font-weight/sorter_esp32/firmware/motion_node/README.md

# Управляющая ESP32: подготовленная прошивка сортировщика

**Принятый вариант: боковой заход +Y на 25 мм. Пользователь подтвердил: «Все. работает. Оставляй».** В arm_calibration команды SORT и CHECKPICK сначала подводят захват к (X,Y−25) на верхнем уровне, опускают там, затем перемещают открытый захват к (X,Y) по нижней карте. Детали должны находиться при X=20…130, Y=50…80 мм. После закрытия выполняется подъём у детали. Пользователь сообщил, что при прежнем отступе 15 мм рука всё равно упёрлась. Отступ 25 мм для кубика размером 30 мм задаёт начало на 10 мм перед ближней гранью. Пользователь подтвердил работу этого варианта; координаты и число выполненных переносов не сообщены. Подробности — в начале `firmware/arm_calibration/README.md`. Настройка сохранена; для её принятия повторная прошивка не требуется.

**История до принятия бокового захода 25 мм: неудачный захват SORT от 12.10.2026.** Пользователь сообщил, что у обоих кубиков рука ушла примерно на 10 мм вперёд и прижала их сверху. Уточнено направление +Y. После неудачного захвата пользователь сам передвинул кубик: уменьшение числа объектов и SORT_PICK_DONE не подтверждают физический перенос и не доказывают ошибку камеры. Момент появления смещения пока неизвестен. Результат записан в `measurements/commissioning/stage17_result.json`. После этой неудачи изменён способ подхода; работу варианта с отступом 25 мм пользователь впоследствии подтвердил. Программные проверки не подтверждают физическую точность захвата.

После местной поправки пользователь измерил HIGH=115/46/103, NEAR=115/46/30, LOW=115/46/10 мм. Все три остановки имеют одинаковые X/Y в пределах записанных измерений, с остаточным смещением Y=+3,7 мм от прежней цели. После упора при боковом подходе на 15 мм пользователь увеличил отступ до 25 мм. Эти местные ручные позы сохранены как измерения; глобальная карта автоматически ими не заменяется.

**Текущий режим motion_node — виртуальный, физические PWM выключены.** В `LocalConfig.h` сохранена карта нынешней MeArm; PARK по просьбе пользователя заменён импульсами **1500,1200,1500,2100**, его XYZ ещё не измерены и measured_ok=false. Значение `parkOpen.tip` временно взято из HUB только для численного виртуального профиля, оно не описывает физический PARK. Повторяемость, точность интерполяции и просветы всех маршрутов ещё не подтверждены: `geometryConfirmed`, `routesVerified`, `parkSupported` остаются `false`. Записанная карта пока не допускает аппаратную сортировку.

Контрольные замеры 12.10.2026: в `measurements/mearm_setup/pose_repeatability.csv` одиннадцать записей проб и проверок. Пользователь принял реальный верхний центр X=75, Y=52,5, **Z=99 мм** и свежим POSE подтвердил **1441,1426,1220,2100 мкс**. Число плеча 1406 в сообщении о финальной позе исправлено на 1426; прежняя отдельная проба 1406 остаётся в журнале как история. В карту добавлены строки `grid_center_high` с этим измерением и пока пустая `grid_center_low`; исходные измерения сохранены; прежний PARK архивирован, для нового PARK пока известны только импульсы. Новая версия включает реальный верхний центр в интерполяцию, нижний пока отключён. Программные проверки и Arduino-сборка прошли; агент плату не прошивал. Пользователь затем выполнил живой виртуальный цикл этапа 14.

Сборка предназначена для Arduino ESP32 3.3.12 и общей библиотеки `sorter/libraries/SorterCore`. Используется встроенный LEDC, дополнительная библиотека ESP32Servo не требуется. Пример профиля платы — обычная ESP32-WROOM; он не подходит автоматически к ESP32-CAM, WROVER, S3 или C3.

## Что уже реализовано

- Состояния DISARMED → PARK_SETTLING → WAIT_SCENE → MOVING → парковка и новый снимок. При пустом поле — DONE.
- Ровно один выбранный объект на снимок. Два контейнера: красный класс `1` → `binHighOpen[0]/binDropOpen[0]`; синий класс `3` → `binHighOpen[1]/binDropOpen[1]`. Зелёный класс `2` отклоняется. Номера классов сохранены от прежней версии UART. Координаты камеры — десятые доли миллиметра.
- Отдельный UART1. Кадры и CRC соответствуют `INTERFACES.md`. Каждому новому снимку присваивается новый SEQ; два повторных запроса сохраняют прежний SEQ.
- D принимается только для текущих SESSION/SEQ/calibration_id и только в ожидании снимка. Дубликат не запускает второй захват. Изменение camera_boot в ходе партии приводит к FAULT.
- После RELEASE рука возвращается в PARK, ждёт 800 мс, затем запрашивает новый снимок. Если выбранный цвет остался в пределах 12 мм от прежнего центра после двух попыток, происходит FAULT. Это предел повторных попыток, а не доказательство неисправности захвата.
- Проверяются допустимые импульсы всех точек маршрута, границы заявленных координат и высот; команды изменяются плавно. Для текущего виртуального профиля срок партии 15 минут; аппаратный лимит остаётся 5 минут, число попыток — 12.
- На каждой программной остановке и при потере ENABLE32 снимается PWM. В аппаратном режиме контроль силовых 5 В отключён: потерю питания прошивка не обнаруживает. Оператор обязан выполнить DISARM до восстановления питания приводов, затем явно начать новую партию.

`cleared` означает «предмет больше не обнаружен в старом месте». **Это не подтверждение попадания в правильный контейнер**: у SG90 и захвата нет обратной связи, датчика падения также нет.

## Этап 17: порядок SORT после устранения промаха

Этап 16 завершён в одной точке: пользователь прислал `AIM_TARGET x_mm=41.6 y_mm=70.1 predicted_z_mm=99.6 command_us=1537,1601,1303,2100` и подтвердил «все совпало». Это наблюдение совпадения центров сверху; фактическая Z и нижняя поза этим не измерены. Результат сохранён в `measurements/commissioning/stage16_result.json`. Этап 15 ранее завершился попаданием красной детали в контейнер без проблем.

Теперь в **arm_calibration** используется команда **SORT**: свежий снимок из PARK, наведение по координатам, захват, выбор красного или синего контейнера, возврат в PARK и следующий снимок. Каждая деталь проходит 14 поз; открытый захват — 2100 мкс, удержание нынешнего кубика — 1250 мкс. Камера, проводка и положение контейнеров прежние. Основная motion_node остаётся виртуальной; нижний центр и XYZ PARK не подменяются расчётами.

1. Если рука после AIMRED ещё удерживается над кубиком, вернуть её командами `MOVE 1500,1500,1500,2100`, затем `MOVE 1500,1200,1500,2100`. После каждой дождаться HOLDING и наблюдать свободный ход. Если она уже в PARK, эти перемещения пропустить. Поддержать PARK, DISARM, выключить силовые 5 В и загрузить обновлённую **arm_calibration только в WROOM**. Монитор — 115200, «Новая строка». Сборка SORT на Arduino ESP32 3.3.12 и программные проверки прошли; последующее физическое испытание выявило промах при захвате обоих кубиков, см. актуальный результат в начале документа.
2. При физически сохранённом PARK отправить `SEED 1500,1200,1500,2100`, `SUPPORTED`; включить 5 В и ENABLE32, затем `ARM`, дождаться HOLDING. SEED сообщает нынешнюю позу и сам руку не перемещает. После устойчивого удержания убрать мешающую опору.
3. После проверки свободного бокового захода поставить два одинаковых по размеру кубика: красный примерно **X40/Y60**, синий **X100/Y60 мм**. Центры должны быть в **X=20…130, Y=50…80 мм**; расстояние между любыми двумя центрами не меньше **30 мм**, лучше 40 мм. Убрать руки из зоны и отправить `SORT` один раз. Контейнер 1 — красный, контейнер 2 — синий.
4. До конца партии не добавлять и не убирать детали вручную. После каждого переноса программа возвращается в PARK, ждёт 800 мс и получает новый кадр. Проверяется исчезновение прежней цели в радиусе 8 мм, уменьшение числа деталей выбранного цвета ровно на одну и неизменное число другого цвета. Ошибка останавливает партию без повторного захвата.
5. При успехе ожидается `SORT_RESULT sorted=2 red=1 blue=1 returned_park_command=1; confirm bins by observation.` и state=HOLDING, trial=DONE, camera_action=SORT. Посмотреть, действительно ли обе детали внутри своих контейнеров. Командный результат сам этого не измеряет.
6. Если партия прошла без зацепов, гудения и промахов, повторить три партии по два кубика в (40,60) и (100,60) мм, меняя цвета местами. Из удерживаемого PARK снова отправлять `SORT`; сохранить каждую строку SORT_RESULT, ожидается sorted=2, red=1, blue=1. Детали перекладывать только между завершёнными партиями. Прежняя раскладка в два ряда с Y=35 мм для отступа 25 мм не подходит.
7. После завершения поддержать PARK, отправить DISARM и выключить силовые 5 В. Записать число доставленных в правильные контейнеры, промахов и время каждой партии; снять видео полного цикла для защиты.

За один запуск разрешены максимум 8 попыток переноса (sortAttempts) и 15 минут; ответ камеры ожидается 6 секунд. Лимит партии не отменяет абсолютные 30 минут ручной сессии. SORT, AIMRED и TRIALRED взаимно исключены. Ошибки `OBJECT_OUTSIDE_SORT_AREA`, `PARTS_TOO_CLOSE`, `TARGET_STILL_PRESENT`, `SCENE_CHANGED_UNEXPECTEDLY`, `SORT_ROUTE_INVALID`, `BATCH_TIME_LIMIT`, `CAMERA_TIMEOUT` требуют остановки и устранения причины, не автоматического повторения. При касании или сильном гудении — ESTOP либо разомкнуть ENABLE32. При выключении силовых 5 В выполнить DISARM до восстановления питания.

Это объединённое заключительное испытание стенда под наблюдением. Верхняя карта использует измеренный центр, нижняя — измеренные углы и интерполяцию между ними. Точный захват всей области, синий маршрут и повторяемость партии сейчас проверяются; нижний центр и XYZ PARK остаются неизвестны. Флаги geometry/routes/parkSupported основной motion_node не включаются. Подробная инструкция — `firmware/arm_calibration/README.md`.

## Этап 15: завершённый TRIALRED — справочный порядок

Ниже сохранён порядок выполненного опыта. Поля STATUS описывают ожидаемый формат, а не полученный от пользователя лог.

Пользователь прислал итог этапа 14: **DONE, error=NONE, attempts=2, cleared=2, physical_pwm=0, seq=3, stale=0, batch_limit_ms=900000**. Исходный ответ сохранён в `measurements/commissioning/stage14_result.json` как история прежнего профиля. Это успешный виртуальный цикл с настоящей камерой; физического переноса в нём не было. Теперь по просьбе пользователя **PARK 1500,1200,1500,2100** служит началом, положением обоих снимков и возвратом TRIALRED. Ранее подтверждённая физическая HIGH 1600,1700,1350,2100 остаётся подходом над 20/80. CAMSCAN одной красной на 20/80 ранее подтверждён сообщением без сырого OBJECT; count/color/±15 мм из нового PARK проверит сама TRIALRED.

Для этапа 15 загрузить **только новую arm_calibration в WROOM**, камера и UART остаются прежними. Обновление с PARK собрано на Arduino ESP32 3.3.12 и проверено программно; испытание TRIALRED на механике затем успешно выполнено пользователем. Основную motion_node не включать в аппаратный режим: MOTOR_OUTPUTS_ENABLED/PINOUT_CONFIRMED и geometry/routes/parkSupported остаются false, нижний центр неизвестен. Один фиксированный красный путь не подтверждает интерполяцию всего поля, синий маршрут или измеренные XYZ/опору физического PARK.

Короткий порядок; подробное подключение и ответы находятся в **firmware/arm_calibration/README.md**:

1. Если настоящая arm_calibration ещё HOLDING в подтверждённой HIGH, отправить MOVE 1500,1500,1500,2100, ждать HOLDING, затем MOVE 1500,1200,1500,2100 и опять HOLDING, наблюдая путь. Если физически известный PARK уже удерживается, переход пропустить. При DISARMED или смещении не принимать виртуальный STATUS за физическую позу. Поддержать новый PARK, DISARM, выключить силовые 5 В и загрузить arm_calibration, сохранив позу.
2. На WROOM USB 115200 отправить **SEED 1500,1200,1500,2100** и SUPPORTED. Включить 5 В/ENABLE32, затем ARM; ожидать HOLDING, outputs=1, camera_uart=1. Не использовать слепой SEED, PARKCONFIRM для этой прошивки не нужен.
3. Поставить ровно одну прежнюю красную деталь на 20/80 в проверенной ориентации и отправить **TRIALRED**. Первый снимок из PARK требует count=1/red и ±15 мм по X/Y. Затем рука проходит 14 поз через HUB_OUT, APPROACH_HIGH и прежний красный маршрут с удержанием 1250, возвращаясь через HUB_RETURN в PARK_RETURN. Это фильтр входа к фиксированной точке, не коррекция захвата по карте.
4. **SIM_REMOVE не используется, оператор деталь не убирает.** Наблюдать попадание внутрь красного контейнера и просвет. При упоре/гудении остановить и поддержать руку. Дополнительные MOVE/JOG или сканирования во время опыта не отправлять.
5. После TRIAL_STEP 14/14 name=PARK_RETURN, завершения движения и выдержки 800 мс свежий кадр из PARK с count=0 даёт **TRIAL_RESULT scene_cleared=1 returned_park_command=1**. Итоговый STATUS: HOLDING, outputs=1, command_us=1500,1200,1500,2100, trial=DONE, trial_error=NONE. Затем поддержать PARK, DISARM и выключить 5 В. Успешный конец не снимает PWM автоматически.

Скопировать TRIAL_RESULT и STATUS, сообщить «взял / отпустил внутри красного / вернулся в PARK / проблемы». Пустой кадр не доказывает правильный контейнер, а returned_park_command не измеряет положение SG90. START_PARK_REQUIRED означает отсутствие требуемой командной позы, её нельзя исправлять слепым SEED. На ответ камеры отведено 6 секунд, на однократный опыт 3 минуты, автоматических повторных попыток нет. Старые этапы 11/12/14 сохранены ниже как история прежних команд.

## Этап 14: завершённая виртуальная сортировка, справка

Пользователь подтвердил этап 13 словами «всё работает»: пустая сцена, красная/синяя детали и встроенная подсветка; сырых логов этапа 13 нет. Последовательность **ARM → Q → настоящий D камеры → выбор цели → виртуальные фазы** этапа 14 завершена по полученному итоговому STATUS. Ниже сохранён её порядок; повторять виртуальные партии для этапа 15 не требуется.

### Подготовить только управляющую прошивку

Оставить прежнюю проводку camera TX13 → WROOM RX16, WROOM TX17 → camera RX14 и общую землю. Камера с автоматическим LED уже актуальна; её не перепрошивать. Силовые 5 В сервоприводов остаются отключёнными, рука на опоре вне обзора. Положение камеры, ROI, цвета и calibration_id=1573755510 сохранить.

На этом компьютере **SorterCore уже обновлена**, повторно копировать библиотеку вручную не требуется. На другом компьютере обновить её из текущего проекта: motion_node использует `MotionController::selectedTarget()`. В этапе 14 загружалась **motion_node.ino в WROOM**, монитор 115200 бод, «Новая строка». Версия собрана и программно проверена, пользовательский итог приведён выше. Для текущего этапа 17 загружается arm_calibration с SORT.

Настройки остаются VIRTUAL_MODE=true, MOTOR_OUTPUTS_ENABLED=false, PINOUT_CONFIRMED=false, UART_PROFILE_CONFIRMED=true. geometryConfirmed/routesVerified/parkSupported false, нижний центр отсутствует. Виртуальная партия теперь ограничена **15 минутами** (`batch_limit_ms=900000`); аппаратный лимит 5 минут не менялся. Виртуальное время идёт с обычной скоростью.

| Поле STATUS | Значение в этом этапе |
|---|---|
| `mode` | VIRTUAL_NO_PWM |
| `physical_pwm` | **0 на всём протяжении** |
| `outputs` | Логическая активность контроллера: 1 после ARM, 0 в DISARMED/DONE |
| `uart` | 1, настоящая камера подключена |

Во время партии не отправлять CAMSCAN, SCENE или FRAME: камера сама отвечает на обычные запросы. Ручные данные сцены и автоматическое скрытие объектов не используются.

### 1. Сначала пустое поле

Убрать детали. Отправить по одной строке:

```text
STATUS
PARKCONFIRM
ARM
```

Сначала ожидается DISARMED и physical_pwm=0. После ARM контроллер проходит виртуальную PARK_SETTLING/WAIT_SCENE, сам запрашивает камеру; `LIVE_SCENE count=0` завершает партию состоянием DONE. Виртуальный PARKCONFIRM разрешает программный запуск и не меняет флаг физической парковочной опоры.

### 2. Один прогон с красной и синей деталями

После DONE поставить две раздельные детали внутри прежнего поля X20…130/Y25…80, примерно красную около 50/45, синюю около 100/65. Отправить по одной строке **PARKCONFIRM**, затем **ARM**. Камера отвечает сама: ручная SCENE и CAMSCAN во время партии не нужны.

Ожидается LIVE_SCENE count=2, затем SORT_TARGET с одним выбранным объектом. `class=1 color=red bin=1` означает красный контейнер, `class=3 color=blue bin=2` — синий. Координаты и pixels берутся из настоящего D; порядок цветов заранее не задан.

**При входе в RELEASE появится SIM_REMOVE. Сразу убрать из поля только указанную деталь и свою руку**, вторую оставить. До следующего запроса обычно около 40 секунд, но не ждать WAIT_SCENE; 15 минут — лимит всей партии, не время ожидания удаления. Рука не переносит предметы, physical_pwm остаётся 0.

Следующий свежий кадр должен дать count=1, выбрать оставшуюся деталь и вывести её SORT_TARGET. Убрать вторую только при её собственном SIM_REMOVE. Затем LIVE_SCENE count=0 и DONE. Две детали проходят виртуальные фазы примерно за 3,5–4 минуты, без ускорения времени.

Программа не маскирует объект и не подставляет пустой ответ. Если выбранная деталь осталась или убрана другая, после двух попыток ожидается TARGET_STILL_PRESENT. Остановить DISARM при необходимости; после RESET из ошибки или DISARM снова нужны PARKCONFIRM и ARM.

Одиночную красную или синюю партию выполнять только для выяснения причины отказа; это не дополнительные обязательные прогоны. Для этапа достаточно пустой партии и одной партии с двумя цветами.

**Результат этапа:** скопировать LIVE_SCENE, SORT_TARGET, SIM_REMOVE и итоговый STATUS/DONE либо ошибку. physical_pwm должен оставаться 0. Проверяется выбор цвета/контейнера, последовательность и обновление живой сцены; это не физический перенос и не допуск аппаратной сортировки.

## Этап 13: завершённая диагностика камеры, справка

При новом CAMSCAN белый LED GPIO4 камеры автоматически включается перед съёмкой; после ожидания 100 мс берётся свежий кадр, затем LED выключается. Это выполняет camera_node по обычному Q, протокол и motion_node не изменены. Для обновления подсветки перепрошить только ESP32-CAM; дополнительных проводов и движений руки не нужно. RGB-пороги и калибровка сохранены; при засветке или ухудшении цветов потребуется подстройка освещения/порогов по результату.

Пользователь подтвердил ручные этапы 11 и 12: захват с удержанием и возвратом, затем доставка в красный контейнер, отпускание внутри и возврат без проблем. Это два сообщённых функциональных опыта в `measurements/mearm_setup/functional_tests.csv`. В этапе 13 движения руки не выполнялись. Пользователь подтвердил успешную UART-диагностику и LED; ниже сохранён её справочный порядок.

### Подключение и две прошивки

1. В действующей arm_calibration поддержать руку и DISARM, выключить питание стенда. Отключить **силовые 5 В сервоприводов** на весь этап. Закрепить руку на опоре вне обзора деталей; камеру, основание, старые оси и освещение сохранить.
2. При выключенном питании соединить GPIO13 TX камеры → GPIO16 RX WROOM, GPIO17 TX WROOM → GPIO14 RX камеры и GND → GND. Сигналы напрямую, уровни 3,3 В; UART не требует последовательных резисторов или преобразователя уровней. MicroSD не используется, её GPIO13/14 заняты UART. Каждая плата питается своим USB/программатором; плюсовые 5 В разных источников не соединять. Земля общая.
3. Загрузить **camera_node.ino** в ESP32-CAM и **motion_node.ino с CAMSCAN** в управляющую ESP32. Камеру программировать штатными GPIO1/3; после загрузки снять IO0–GND для обычного запуска и перезапустить. GPIO13/14 остаются межплатным UART. На обеих платах использовать текущую SorterCore.

Текущие настройки этапа 13:

| Камера | Управляющая ESP32 |
|---|---|
| CAMERA_PROFILE_CONFIRMED=true | VIRTUAL_MODE=true |
| CAMERA_UART_PINS_CONFIRMED=true | MOTOR_OUTPUTS_ENABLED=false |
| VISION_CONFIG_CONFIRMED=true | PINOUT_CONFIRMED=false |
| CALIBRATION_CONFIRMED=true, ID=1573755510 | UART_PROFILE_CONFIRMED=true, calibrationId=1573755510 |

`geometryConfirmed`, `routesVerified`, `parkSupported` остаются false. Нижний центр не добавлять. Матрицу, ROI, цвета и сенсорные настройки камеры не менять; повторная калибровка для этого этапа не требуется. Виртуальный режим здесь отключает PWM, но UART действительно обращается к физической камере.

### Проверка с USB-консолей

1. **Монитор камеры — 460800 бод**, «Новая строка». Отправить STATUS. Ожидаются поля `CAMERA=1 UART=1 VISION_CONFIRMED=1 CALIBRATION=1 ID=1573755510`.
2. **Монитор управляющей ESP32 — 115200 бод**. Отправить STATUS: ожидаются `mode=VIRTUAL_NO_PWM`, `state=DISARMED`, `outputs=0`, `uart=1`, `camscan_pending=0`.
3. Убрать детали и на **управляющей плате** отправить **CAMSCAN**. Сначала CAMSCAN_WAIT, затем CAMSCENE с count=0. Одна команда отправляет настоящий Q и ждёт соответствующий D/E максимум 6 секунд. Работает в DISARMED/DONE при виртуальном режиме и выключенных выходах; ARM и PARKCONFIRM не нужны.
4. Поставить отдельно красную и синюю детали внутри X=20…130, Y=25…80 мм, примерно около **50/45 и 100/65**. Точной раскладки для этой проверки не требуется. Между деталями оставить промежуток, их полные области должны быть внутри калиброванного участка камеры. Повторить CAMSCAN: ожидаются count=2 и два OBJECT — class=1 color=red, class=3 color=blue.
5. Отправить STATUS после ответа. Состояние остаётся DISARMED, outputs=0, camscan_pending=0. Скопировать **CAMSCENE, OBJECT и этот STATUS**. При отказе скопировать сообщение ошибки; POSE и ручные XYZ не нужны.

Формат ответа содержит реальные значения:

```text
CAMSCENE count=... calibrationId=1573755510 boot=...
OBJECT class=1 color=red x_mm=... y_mm=... pixels=... in_pick_area=...
OBJECT class=3 color=blue x_mm=... y_mm=... pixels=... in_pick_area=...
```

Многоточия здесь обозначают формат, не измеренные числа. x_mm/y_mm — миллиметры, pixels — площадь области. in_pick_area показывает попадание центра в прямоугольник карты, а не физическую досягаемость руки или точность захвата.

| Сообщение | Что проверить |
|---|---|
| CAMSCAN_TIMEOUT | За 6 секунд нет подходящего ответа: питание/запуск камеры, общую землю, перекрёстные TX/RX и UART=1 |
| CAMSCAN_ERROR code=... | Камера ответила E; сохранить код, проверить её STATUS и одинаковый ID |
| UART_DISABLED | В управляющей прошивке UART не готов; нужен подготовленный UART_PROFILE_CONFIRMED=true |
| HARDWARE_MODE | Для этой команды оставить VIRTUAL_MODE=true и моторные выходы выключенными |

Не отправлять SCENE, FRAME с ручным CRC, ARM или PARKCONFIRM для получения этой сцены. На USB камеры SCAN/SCAN_MM заблокированы при UART=1; CAMSCAN отправляется только с консоли управляющей платы. Межплатный UART — **115200 8N1** с обеих сторон, USB камеры — **460800**. Программные проверки CAMSCAN и сборка обеих прошивок прошли на ESP32 3.3.12; загрузки агентом и работы с аппаратурой не было. Пользователь затем подтвердил работу связи, но сырые логи этой проверки не предоставил.

## Отдельный синтетический прогон: справка, не этап 15

На компьютере полноценный цикл проверяется `tests/test_motion.cpp` без плат. Для отдельной синтетической демонстрации сохранить VIRTUAL_MODE=true и моторные выходы выключенными, но собрать её с UART_PROFILE_CONFIRMED=false и отключённой камерой. При активном UART камера отвечает сама, поэтому ручная SCENE может конфликтовать с живым ответом. В текущем этапе 14 UART не отключать и SCENE не использовать; физические приводы не требуются. USB-консоль: 115200 бод, завершение команд переводом строки.

1. Отправьте `STATUS`: будет `mode=VIRTUAL_NO_PWM` и `state=DISARMED`.
2. Отправьте `PARKCONFIRM`, затем `ARM`.
3. При `WAIT_SCENE` отправьте `SCENE 456,1573755510,1;1,750,525,250`. Это синтетическая красная деталь класса 1 в центре текущего поля: x=75 мм, y=52,5 мм. Указанные 250 пикселей также являются тестовым значением. Значение `1573755510` — текущий `calibrationId` в `LocalConfig.h`; при смене калибровки оно должно совпадать с новым ID контроллера и камеры. Это демонстрация `VIRTUAL_NO_PWM`, не команда физического перемещения к центру.
4. Будут последовательно выведены фазы HUB_OUT, APPROACH, DESCEND, GRIP, LIFT, HUB_LOADED, BIN_APPROACH, BIN_LOWER, RELEASE, BIN_LEAVE, HUB_RETURN, PARK. С нынешними ограничениями виртуальный перенос занимает около двух минут; дождитесь следующего WAIT_SCENE. Во время MOVING ответ сцены не требуется.
5. После нового `WAIT_SCENE` отправьте `SCENE 456,1573755510,0`: поле пустое, переход в DONE.

На ответ при WAIT_SCENE есть 18 секунд: первый запрос и два повторения с тайм-аутом по 6 секунд. Этот срок не относится к ожиданию самого переноса. Длительное молчание при WAIT_SCENE ожидаемо завершится `CAMERA_TIMEOUT`. Виртуальная команда `SCENE` подставляет текущие SESSION/SEQ; для проверки неверных/старых кадров используйте `FRAME <полный ASCII-кадр с CRC>`. В текущем виртуальном профиле лимит партии 15 минут, аппаратный лимит остаётся 5 минут. Следить за batch_limit_ms в STATUS; пример синтетической сцены сам настройки времени не меняет.

Команды `SIMPOWER 0` и `SIMENABLE 0` моделируют потерю условий в виртуальном режиме. После восстановления через `SIMPOWER 1` / `SIMENABLE 1` состояние остаётся DISARMED. Для нового запуска опять нужны PARKCONFIRM и ARM. SIMPOWER — вход имитатора, а не показание физического датчика: в текущем аппаратном подключении такого контроля питания нет.

## Команды управления

| Команда | Действие |
|---|---|
| `HELP`, `STATUS` | Список команд и текущие данные |
| `CAMSCAN` | Один живой запрос камеры без PWM, только в DISARMED/DONE при VIRTUAL_MODE=true и готовом UART |
| `PARKCONFIRM` | Однократное подтверждение оператором исходной парковочной позы; допускается только из DISARMED/DONE |
| `ARM` | Новая партия и новая SESSION; подтверждение парковки расходуется даже при неудачном запуске |
| `PAUSE` | Прекратить изменение текущей команды, продолжать удерживать PWM; максимум 30 секунд |
| `RESUME` | Продолжить из удерживаемой команды плавно; если остановлено ожидание снимка — запросить новый SEQ |
| `DISARM` | Снять PWM, перейти в DISARMED, сбросить разрешение парковки |
| `ESTOP` | Немедленно прекратить программные выходы и зафиксировать FAULT |
| `RESET` | Сбросить FAULT в DISARMED; движения не запускает |

**PAUSE удерживает усилие и не является аварийным отключением.** DISARM/ESTOP могут привести к опусканию ненагруженной током руки; конструкция должна иметь опору. Программный ESTOP не заменяет отдельного выключателя силовой цепи сервоприводов.

## Подключение после идентификации платы

В текущем этапе 13 моторные GPIO и входы не настраиваются, а UART1 включён отдельным UART_PROFILE_CONFIRMED=true. USB Serial остаётся консолью. Пользователь указал ESP32-WROOM-32U DevKitC V4 и проверил четыре SG90 при прямом подключении. Ниже приведён профиль этой платы; проверка приводов по одному не подтверждает карту движения собранной MeArm.

| Назначение | GPIO примера | Подключение |
|---|---:|---|
| Основание, плечо, рычаг, губки | 25, 26, 27, 33 | Напрямую к сигналам SG90; 3,3 В, от каждого сигнала 10 кОм к GND |
| HARDWARE_ENABLE | 32 | 3,3 В = разрешено; LOW/обрыв = запрет, используется INPUT_PULLDOWN |
| UART1 RX | 16 | TX камеры, уровень 3,3 В |
| UART1 TX | 17 | RX камеры, уровень 3,3 В |

KiCad по просьбе пользователя оставлен в прежнем виде: путь PWM и силовое питание не описывают новую прямую проводку. Вход HARDWARE_ENABLE (32) также отсутствует в KiCad. Моторный аппаратный режим выключен; включение UART для этапа 13 его не разрешает. Контроль силового питания удалён из текущего профиля всех трёх программ: `motion_node`, `arm_calibration` и `servo_diagnostic`. GPIO23/34 не подключаются, делитель АЦП не нужен.

Земля источника сервоприводов, управляющей платы и камеры должна быть общей. Питание SG90 около 5 В идёт отдельной силовой ветвью; при питании ESP32 по USB внешний плюс приводов не подключается к её 5V/VIN. Сигналы подключаются напрямую, без последовательных резисторов; на каждом из четырёх сигналов — один резистор 10 кОм к GND. Преобразователь уровней не используется. UART соединяется напрямую: GPIO16 RX ↔ GPIO13 TX камеры, GPIO17 TX ↔ GPIO14 RX камеры. **5 В нельзя подавать на GPIO или 3V3.**

Вход HARDWARE_ENABLE подключается к переключателю между 3V3 ESP32 и GPIO32. При FALLING входа фиксируется защёлка; программное отключение выполняется в следующем проходе цикла. Этот переключатель разрешает сигналы, но не разрывает питание. Физический выключатель силовой ветви отключает приводы независимо от ESP32, USB и UART.

Прошивка замечает задержку своего цикла больше 250 мс и снимает PWM при следующем выполнении. Она не способна выключить выход, пока сам процессор полностью завис. При исчезновении силовых 5 В работающая от USB ESP32 может продолжить выдавать PWM и выполнять программу. Поддержать руку и отправить DISARM **до восстановления 5 В**; иначе их возвращение может сразу вызвать движение. Для нового запуска нужны PARKCONFIRM и ARM. Статус отсутствия контроля питания не является измерением напряжения.

## Почему здесь нет стандартной формулы для двухзвенной руки

MeArm содержит связанные звенья и тяги. Подстановка универсальной формулы «два свободных звена» без измерения конкретной геометрии дала бы ненадёжные команды. Основа карты — **прямоугольная сетка 2×2** отдельно для нижнего и верхнего положения захвата. При выключенных дополнительных центрах сохраняется исходная билинейная интерполяция. При включённом центре прямоугольник разделяется на четыре треугольника, узлами которых служат соседние углы и измеренный центр. Угловые команды и прежняя арифметика на внешних краях сохраняются. Сейчас верхний центр включён, нижний отключён; за пределами прямоугольника подход к детали запрещён.

Текущие записанные границы — X=20…130, Y=25…80 мм, участок 110×55 мм. Нижний Z углов 10 мм, верхний 100 мм; реальный верхний центр имеет Z=99 мм. На верхнем уровне заданная высота интерполируется между 99 и 100 мм по этим узлам; это не доказательство фактической высоты пальцев во всех промежуточных точках. Высота детали и плоскости камеры 27 мм не заменяет Z пальцев. Опечатка Y=85 исправлена по уточнению пользователя: во всех углах maxY=80. Совпадение углов и центра ещё не подтверждает остальные точки поля. Дополнительные строки журнала сами карту не меняют; при неприемлемой ошибке поле уменьшить или уточнить модель.

Билинейная комбинация сохраняет диапазоны PWM, но **не доказывает реальную высоту пальцев, отсутствие столкновений и вертикальность траектории**. Без обратной связи и модели кинематики программная проверка касается только заданных точек и импульсов. Поэтому аппаратный запуск требует ручной проверки промежуточных положений и всех переходов на настоящем стенде. Флаг `routesVerified` фиксирует результат такой проверки; он не вычисляет его автоматически.

Маршрут каждой детали: PARK → HUB → верх над деталью → низ → закрытие → подъём → HUB → верх контейнера → положение сброса → открытие → верх контейнера → HUB → PARK. Движение выполняется синхронной интерполяцией импульсов суставов; оно не является прямолинейным декартовым перемещением. HUB записан, но все пути через него ещё требуют физической проверки.

## Что записано и что проверить следующим

Все позы ниже имеют открытие **2100 мкс**. Координаты в таблице — мм, три команды — каналы 0/1/2 в мкс. Система X/Y и calibrationId 1573755510 остаются такими же, как у камеры.

| Поза | X / Y / Z, мм | Основание / плечо / рычаг, мкс |
|---|---|---|
| minX/minY low | 20 / 25 / 10 | 1700 / 2000 / 500 |
| maxX/minY low | 130 / 25 / 10 | 1150 / 2000 / 500 |
| minX/maxY low | 20 / 80 / 10 | 1600 / 2150 / 850 |
| maxX/maxY low | 130 / 80 / 10 | 1250 / 2150 / 850 |
| minX/minY high | 20 / 25 / 100 | 1700 / 1350 / 1250 |
| maxX/minY high | 130 / 25 / 100 | 1200 / 1350 / 1250 |
| minX/maxY high | 20 / 80 / 100 | 1600 / 1700 / 1350 |
| maxX/maxY high | 130 / 80 / 100 | 1250 / 1700 / 1350 |
| PARK для съёмки | XYZ ещё не измерены | 1500 / 1200 / 1500 |
| HUB | 55 / 55 / 110 | 1500 / 1500 / 1500 |
| Красный high | −60 / −25 / 60 | 2100 / 1600 / 850 |
| Красный drop | −60 / −25 / 40 | 2100 / 1800 / 750 |
| Синий high | 255 / −30 / 60 | 800 / 1600 / 850 |
| Синий drop | 255 / −30 / 40 | 800 / 1800 / 750 |
| Дополнительный верхний центр | 75 / 52,5 / 99 | 1441 / 1426 / 1220 |
| Дополнительный нижний центр | Ещё не измерен | Не заданы |

Командные границы `{550,850,500,950}`…`{2450,2150,1650,2100}` включают пользовательское расширение канала 2 до 500 для двух измеренных нижних поз. Оно не подтверждает всю область сочетаний звеньев. Пространственные границы X=−60…255, Y=−30…80, Z=10…110 мм лишь охватывают записанные точки; они не являются измеренной областью всех путей. Скорость 100 мкс/с и ускорение 100 мкс/с² — заданные ограничения, а не измеренные безопасные характеристики механики.

Пользователь сообщил успешные ручные этапы 11 и 12; их два результата хранятся в functional_tests.csv. Пользователь подтвердил UART-проверку этапа 13 и прислал успешный итог виртуального этапа 14. Этапы 15 и 16 завершены: фиксированный красный перенос и верхнее наведение в одной точке; текущий этап 17 выполняет ограниченную партию SORT отдельной arm_calibration. Синий контейнер, нижний центр и все автоматические допуски этим не подтверждены.

Просветы маршрутов в CSV пусты. Одиннадцать контрольных записей не являются проверкой всей области или новых маршрутов. Одиночные JOG не проверяют синхронные автоматические переходы. Один принятый верхний центр не разрешает geometryConfirmed/routesVerified. До отдельных проверок сохранить `VIRTUAL_MODE=true`, `MOTOR_OUTPUTS_ENABLED=false` и три флага калибровочного допуска `false`.

Дополнительные строки CSV `grid_center_high` и `grid_center_low` соответствуют `centerHighOpen` и `centerLowOpen`; координаты из мм умножаются на 10, импульсы не меняются. Для использования нужен перенос в конфигурацию и явный флаг уровня, одного заполнения CSV недостаточно. Сейчас `centerHighEnabled=true`, центр `{750,525,990}` и `{1441,1426,1220,2100}` перенесён; `centerLowEnabled=false`, снизу сохранена исходная билинейная интерполяция. Нижний флаг не включать до реального измерения. Частичное уточнение допустимо для виртуальной проверки, но аппаратная проверка калибровки его отвергает. Для уточнённой аппаратной карты нужны измеренные центры обоих уровней с совпадающими X/Y и нижним Z меньше верхнего, а также отдельные физические проверки геометрии и маршрутов.

## Как заполнить измерения и допустить аппаратный режим

1. Сначала подтвердите профиль платы, прямую проводку с четырьмя подтяжками 10 кОм, питание и выключатель ENABLE32. Для проверки отдельных приводов доступны `servo_bench` или `servo_diagnostic`. Позы собранной поддерживаемой руки измеряйте через `arm_calibration`. Если плечо и связанный рычаг упираются при 1500 мкс, сначала отсоедините тяги и исправьте монтаж качалок; общий запуск в такую позу запрещён.
2. Индивидуальные границы уже внесены по наблюдениям пользователя, включая отдельное подтверждение двух поз канала 2 при 500. Не переносите диапазон 500–2500 мкс из общих характеристик на остальные каналы или все сочетания звеньев. Скорость и ускорение уточнять по реальным испытаниям.
3. Прямоугольник X=20…130, Y=25…80 мм уже выбран. Сохраняйте прежние оси и начало координат; камерная гомография и сетка руки используют одну систему координат и `calibrationId=1573755510`.
4. В `measurements/mearm_setup/motion_calibration.csv` сохранены 16 строк узлов: исходные четыре угла снизу и сверху, PARK, HUB, верх/сброс двух контейнеров и два центра. Дополнительный HIGH измерен, LOW пока пустая. У нового PARK известны только импульсы 1500,1200,1500,2100, XYZ пусты, measured_ok=false; прежняя запись сохранена как история. Z — высота самой низкой части пальцев над столом, а не высота центра детали. Новые измерения и повторные подходы записывайте отдельно, сохраняйте их фактический результат.
5. Значения перенесены в `makeCalibration()` файла `LocalConfig.h`, измеренные узлы отмечены. `minZ10=100` означает 10 мм в координатах записанных точек; это ещё не доказанный просвет от стола с учётом люфта, прогиба и траекторий. Общие флаги геометрии, маршрутов и парковочной опоры остаются выключенными.
6. Проверьте независимые точки внутри сетки: центр, середины рёбер, четыре четверти поля. Их нельзя использовать одновременно и для подгонки, и для заявления независимой точности. Измерьте ошибку в миллиметрах и долю успешных захватов; если ошибка выходит за запас губок, уменьшите поле или доработайте модель.
7. На поддерживаемой руке без груза, затем с лёгкой деталью медленно проверьте все переходы. Особенно важны «верх↔низ» внутри ячейки, переход через HUB и сброс над бортиком. Проверяйте весь путь и минимальный просвет, а не только конечные точки. В худших положениях измерьте нагрев и ток удержания. Не допускайте работы в механическом упоре.
8. Только после этих измерений установите `geometryConfirmed`, `routesVerified`, `parkSupported`. PARK должен механически поддерживать руку при снятом PWM. Повторите проверку при изменении губок, высоты деталей, контейнеров, плеч или монтажных отверстий.
9. Установите `PINOUT_CONFIRMED=true`, `UART_PROFILE_CONFIRMED=true`, `MOTOR_OUTPUTS_ENABLED=true`, `VIRTUAL_MODE=false`. Это изменения конфигурации на компьютере; исходная версия остаётся заблокированной до их выполнения. Неверная/неполная калибровка всё равно блокирует ARM.
10. При первом включении зафиксируйте руку в измеренной парковочной позе при выключенном питании приводов. У SG90 нет чтения фактического угла: включение PWM может вызвать рывок, если реальное положение отличается. Проверьте HARDWARE_ENABLE, подключите питание приводов, поддерживайте руку, затем выполните PARKCONFIRM и ARM. Не считайте PARKCONFIRM автоматической процедурой поиска нуля. При последующей потере 5 В выполнить DISARM до их восстановления.

Для цветов и деталей первой версии нужна круглая форма либо захват, допускающий любой угол поворота. Ориентации в UART v1 нет; обычный повёрнутый квадрат или треугольник ещё не поддержан как самостоятельный класс захвата.

## Что проверить на реальном стенде

- При отключённых силовых 5 В и работающей от USB ESP32 оператор выполняет DISARM и проверяет отключение PWM до возврата 5 В. Автоматическое обнаружение потери питания в этом профиле отсутствует.
- Открытие физического разрешения и обрыв его сигнального провода запрещают управление.
- Повторный D, неверный SEQ, отключение камеры, неверная калибровка и перезапуск камеры не запускают повторный перенос.
- Пауза удерживает текущую команду; после 30 секунд переходит в FAULT. Аварийный силовой выключатель прекращает усилие независимо от программы.
- Между двумя снимками переносится ровно один объект; следующая сцена получена при припаркованной руке.
- Два безуспешных переноса одного объекта завершаются FAULT; вручную вернуть его на поле во время партии нельзя без остановки.

Код использует [`ledcAttach`, `ledcWrite`, `ledcDetach` из официального Arduino ESP32 API](https://docs.espressif.com/projects/arduino-esp32/en/latest/api/ledc.html). Возврат `true` подтверждает настройку периферии, а не движение сервопривода.
