font-weight/sorter_esp32/firmware/servo_diagnostic/README.md

# Проверка SG90 по одному, без автоматического поворота

Исходная прошивка **не включает PWM**: `OUTPUTS_ENABLED=false`, `PINOUT_CONFIRMED=false`. Она подготовлена для Arduino ESP32 3.3.12 и библиотеки SorterCore. Сборка не означает, что конкретные приводы или плата физически проверены.

Программа предназначена для проверки отдельных сервоприводов со снятыми тягами и без нагрузки, а не для перемещения собранной руки. Начальная команда неизвестного SG90 может вызвать поворот: датчика текущего положения нет.

## Подготовка

1. Подтвердите модель управляющей платы и GPIO в `LocalConfig.h`. Для ESP32-WROOM-32U DevKitC V4 выходы 25, 26, 27, 33 соединяются напрямую с сигналами SG90 (уровень 3,3 В), от каждого сигнала резистор 10 кОм идёт к GND. Последовательные резисторы не нужны. Номера GPIO сохранены, но KiCad оставлен в прежнем виде и не описывает новую цепь сигналов. Входа 32 в нём также нет; аппаратные разрешения пока оставить false.
2. Подключите один привод к отдельному проверенному питанию около 5 В с общей землёй ESP32 и источника. Остальные приводы пока не подключайте. Не подавайте силовое питание через ESP32 и не соединяйте внешний плюс с 5V/VIN платы, пока она питается по USB.
3. Сделайте физическое отключение питания привода. ENABLE32 подключите к переключателю на 3V3 ESP32; LOW или обрыв запрещает движение, работает внутренняя подтяжка вниз. Контроль силового питания отключён, GPIO23/34 не подключаются; датчик, делитель и перемычки для имитации питания не требуются. **Подавать силовые 5 В прямо на GPIO запрещено.**
4. Оставьте узкий исходный диапазон 1400–1600 мкс. Он не является механической калибровкой. Для конкретного экземпляра при необходимости сначала уточните допустимые сигналы по его документации; при отсутствии сведений держите тяги снятыми и питание доступным для немедленного отключения.
5. После проверки подключения установите два разрешающих флага в true и соберите прошивку. При старте всё равно ни один PWM не включается.

## Команды USB-консоли

Скорость 115200, команды завершаются переводом строки.

| Команда | Результат |
|---|---|
| `HELP`, `STATUS` | Помощь, выбранный канал, текущая/целевая длительность импульса |
| `ARM 0 1500` | Подключить **только** канал 0 и явно задать начальные 1500 мкс; разрешены индексы 0–3 |
| `US 1550` | Медленно изменить команду до 1550 мкс; шаг не больше 100 мкс, итоговая команда в пределах 1400–1600 мкс |
| `DISARM` | Отключить выбранный PWM |
| `ESTOP` | Отключить PWM и зафиксировать ошибку |
| `RESET` | Сбросить ошибку в отключённом состоянии; сам привод не запускается |

Выход обновляется раз в 20 мс, скорость изменения ограничена 100 мкс/с. Первая команда ARM задаёт исходный импульс сразу, поэтому **не гарантирует плавного старта из неизвестного физического угла**. Автоматического sweep, широкого поворота и запуска всех четырёх каналов нет.

После **5 минут** без новой принятой команды ARM/US выход отключается. Явно отправленные STATUS и HELP также продлевают ожидание на 5 минут, когда выход включён и ENABLE разрешён; автоматические сообщения этого не делают. Отдельного общего ограничения сессии в этой программе нет. Она предназначена для ненагруженной диагностики: собранную руку нельзя оставлять без опоры в ожидании отключения.

При исчезновении ENABLE32, ошибке настройки PWM или задержке цикла свыше 250 мс возникает фиксируемая остановка. После восстановления ENABLE выполните RESET и новый ARM; замыкание переключателя само привод не запускает. Спад ENABLE дополнительно фиксируется обработчиком прерывания; это не заменяет аппаратного выключателя силовой цепи.

Программа **не обнаруживает исчезновение силовых 5 В** при работающей ESP32 и может продолжать выдавать PWM. До восстановления 5 В выполните DISARM. Затем включите питание и при готовности отдельно отправьте новую команду ARM. Если оставить PWM активным, возвращение питания может сразу повернуть привод. Отсутствие контроля в STATUS не означает, что напряжение измерено или питание присутствует.

## Какие данные записать

Для каждого экземпляра: маркировка, устойчивое питание без/под нагрузкой, ток холостого хода и удержания без упора, реакция на 1400/1500/1600 мкс, люфт, шум, нагрев и диапазон без механического упора. Перед сменой привода выполняйте DISARM и снимайте питание.

Затем отдельно определите пределы **в собранной механике**. Предел свободного сервопривода нельзя напрямую считать пределом звена MeArm. Уменьшайте диапазон при натяжении тяги, упоре губок или заметном росте тока. До установки тяг сохраните найденную центральную позицию и правильно ориентируйте качалку.

Программа не измеряет ток, напряжение, температуру или фактический угол: значения необходимо получить внешними приборами. `STATUS us=...` — это программная команда PWM.

API PWM: [официальная документация Arduino ESP32 LEDC](https://docs.espressif.com/projects/arduino-esp32/en/latest/api/ledc.html).
