font-weight/sorter_esp32/docs/algorithm.pdf

АЛГОРИТМ ПРОГРАММЫ СОРТИРОВКИ

На рисунке 1 показан основной цикл сортировки красных и синих

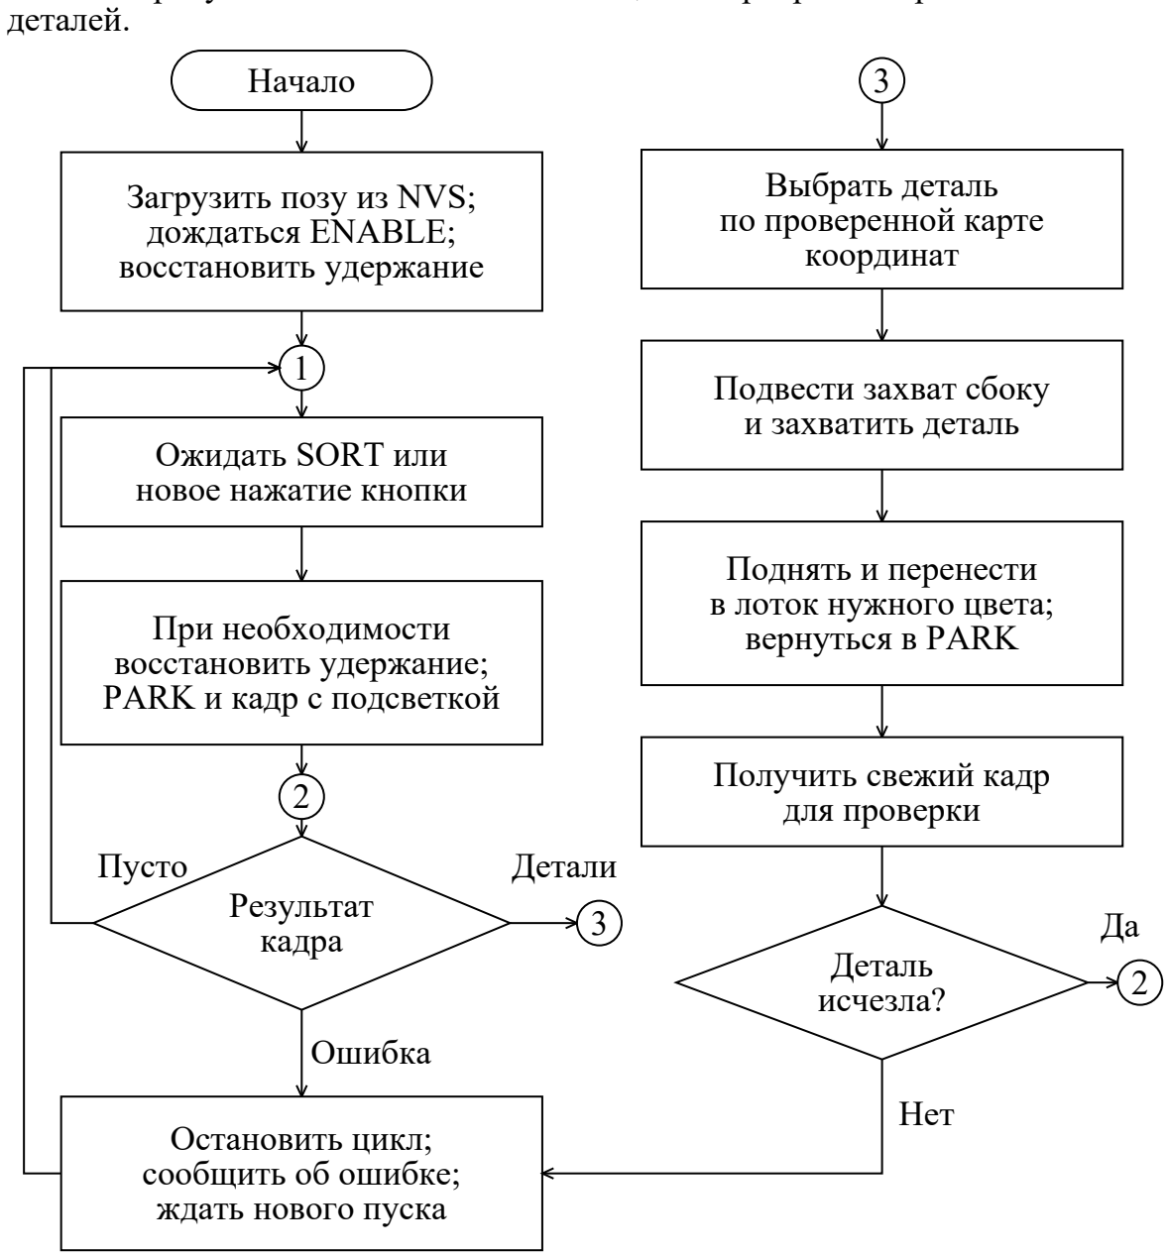
[picture p1: figure]
деталей.; Начало; Загрузить позу из NVS; дождаться ENABLE; восстановить удержание; Ожидать SORT или новое нажатие кнопки; При необходимости восстановить удержание; PARK и кадр с подсветкой; Результат кадра; Ошибка; Остановить цикл; сообщить об ошибке; ждать нового пуска; Пусто; Детали; Выбрать деталь по проверенной карте координат; Подвести захват сбоку и захватить деталь; Поднять и перенести в лоток нужного цвета; вернуться в PARK; Получить свежий кадр для проверки; Деталь исчезла?; Нет

Рисунок 1 – Алгоритм программы сортировки

При потере ENABLE или команде ESTOP ШИМ отключается. После восстановления разрешения нужен новый пуск.
NVS хранит заданную позу, а не измеренное положение. Первый запуск: PARK. Прерванная сортировка автоматически не продолжается.

1
