font-weight/sorter_esp32/examples/synthetic_scene.png

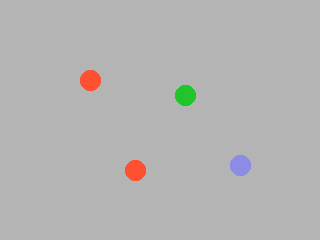
examples/synthetic_scene.png
