font-weight/sorter_esp32/docs/wiring.md

# Подключение стенда

Текущий стенд использует ESP32-WROOM-32U DevKitC V4 и прямое соединение GPIO с сигнальными входами четырёх SG90. Пользователь проверил работу всех четырёх приводов при таком подключении. Работа собранной MeArm под нагрузкой и карта её положений ещё требуют измерений. В прошивках нет отдельного управления преобразователем уровней: PWM создаётся встроенным LEDC.

Файл `KiCad_sorter/sorter_esp32.kicad_sch` по просьбе пользователя оставлен без изменений. Он сохраняет прежнюю цепь сигналов и питание; его экспорт от 03.10.2026 не является схемой новой проводки. Назначения GPIO сохранены, фактическое подключение описано ниже.

## Сигналы текущего стенда

| Назначение | Управляющая ESP32-WROOM-32U | Другой конец |
|---|---|---|
| Приём от камеры | GPIO16 RX | Напрямую к камере GPIO13 TX |
| Передача камере | GPIO17 TX | Напрямую к камере GPIO14 RX |
| Основание, канал 0 | GPIO25 | Сигнал SG90 основания; 10 кОм от сигнала к GND |
| Плечо, канал 1 | GPIO26 | Сигнал SG90 плеча; 10 кОм от сигнала к GND |
| Связанное звено, канал 2 | GPIO27 | Сигнал третьего SG90; 10 кОм от сигнала к GND |
| Захват, канал 3 | GPIO33 | Сигнал SG90 захвата; 10 кОм от сигнала к GND |
| Общая опора сигналов | GND | Общая земля камеры, управляющей платы, приводов и источника |

Сигналы приводов — прямые импульсы уровня 3,3 В от ESP32. Дополнительная микросхема согласования уровней и последовательные резисторы не используются. На каждом сигнальном проводе стоит один резистор 10 кОм к общей земле — всего четыре. Это подтяжка сигнала вниз; она не измеряет питание. Сигналы четырёх приводов между собой не соединять. Большой ток привода через GPIO не протекает: силовое питание подключается отдельно. Проверка имеющихся SG90 не заменяет проверку другого экземпляра при его замене.

Подключение каждого канала:

```text
GPIO ESP32 ───────── сигнальный провод SG90
              │
            10 кОм
              │
общая GND ────┴───── провод GND SG90
внешние +5 В ─────── провод питания SG90
```

UART: 115200 бод, 8N1, уровни 3,3 В. Это не RS-232. Камера использует RX14/TX13; microSD при такой распиновке не используется. USB/программатор остаётся отдельным диагностическим каналом. Адреса I²C, команды и библиотека PCA9685 для приводов не нужны.

## Питание фактического стенда

Четыре SG90 подключаются параллельно к проверенной внешней ветви около 5 В. ESP32 на этапе настройки питается по USB; внешний плюс питания сервоприводов не соединяется с контактом 5V/VIN этой платы. Земли обязательно объединяются. Ток SG90 должен идти по силовым проводам, а не через ESP32 или GPIO. Нужен доступный выключатель силового питания, независимый от программы.

Надпись «15 Вт» на USB-источнике сама по себе не задаёт допустимый ток при 5 В: проверить именно строку 5 В на этикетке и напряжение при работе четырёх приводов. Достаточность источника подтверждается измерением просадок и устойчивостью в нужных положениях руки. Не подавать 5 В на GPIO или контакт 3V3.

## Вход разрешения и отсутствие контроля питания

Для `arm_calibration`, `motion_node` и `servo_diagnostic` остаётся только вход разрешения GPIO32. Подключить переключатель между 3V3 управляющей ESP32 и GPIO32. Вход использует `INPUT_PULLDOWN`: замкнутый переключатель разрешает сигналы, разомкнутый или оборванный провод запрещает их. Дополнительный внешний резистор на GPIO32 не требуется.

Контроль силового питания в текущем профиле отключён. Делитель питания удалён; GPIO23 и GPIO34 не подключаются к сервоприводам, их питанию или 3V3. Нет измерения напряжения, порогов АЦП и цифрового POWER_GOOD. Статус «контроль отсутствует» не является подтверждением наличия 5 В.

Выключатель GPIO32 разрешает сигналы, но сам не разрывает питание приводов. Физический выключатель силовой ветви остаётся доступным для остановки рукой оператора. Прошивка фиксирует потерю ENABLE32, снимает импульсы и требует нового запуска. Это программная реакция; при зависшем процессоре она не заменяет физического отключения силовой цепи.

Если силовые 5 В исчезли при работающей ESP32, прошивка этого не обнаружит и может продолжать выдавать PWM. **До восстановления питания поддержать руку и выполнить DISARM**, затем убедиться в отключении выходов. После восстановления питания в ручной настройке нужны новая известная исходная команда `SEED`, `SUPPORTED` и `ARM`; в автоматической программе — измеренная парковка, `PARKCONFIRM` и `ARM`. Само возвращение 5 В при оставленных активными выходах может сразу вызвать движение.

Включать USB ESP32 при открытом ENABLE32, затем питание приводов; запуск выполнять явными командами. Перед обычным выключением поддержать руку и отправить DISARM, затем отключить питание приводов. Без PWM или питания рука может опуститься; при настройке нужна механическая поддержка.

## Прежний файл KiCad

В сохранённой схеме J1 соединён с SW1 без F1; после SW1 цепи питания приводов и логики объединены, F2 отсутствует. JP1 отключает внешний плюс управляющей платы перед USB и не является отдельным выключателем сервоприводов. Архивная проверка ERC от 03.10.2026 обнаружила одну ошибку (два выхода PWR_FLAG соединены) и одно предупреждение (+5V_LOGIC и +5V_SERVO на общей цепи). Эти результаты относятся к прежнему файлу и не подтверждают новую проводку. При будущей переработке схемы необходимо перенести фактические соединения и повторить ERC.

## Проверка на столе

Сначала проверить полярность и напряжения без приводов. Для свободного SG90 доступна отдельная `servo_bench`; `servo_diagnostic` требует проверенного ENABLE32. После сборки использовать ручную `arm_calibration` для измерения поз, а автоматическую `motion_node` — после заполнения обеих калибровок и проверки маршрутов. Если плечо или связанный рычаг упирается при 1500 мкс, сначала снять тяги и исправить монтаж качалок; не запускать всю руку в эту позу.

Отдельно проверить отключение ENABLE32 при ожидании и движении, отсутствие запуска при его восстановлении, перезапуск логики и обрыв сигнального провода разрешения. Проверку силового отключения выполнять с поддерживаемой рукой: отключить 5 В, выполнить DISARM при работающей ESP32 и только после этого восстановить 5 В. Автоматическое обнаружение такого отключения не ожидается. Соединения, измерения и версию схемы записывать в каталог нового сеанса.
