font-weight/sorter_esp32/firmware/arm_calibration/README.md

# Ручная настройка собранной MeArm

Текущая заданная скорость `arm_calibration` — **300 мкс/с**, втрое выше прежних 100 мкс/с. Она применяется к SORT, CHECKPICK, TRIALRED, AIMRED, MOVE и JOG, включая привод захвата. Отступ 25 мм, конечные позы и паузы сохранены; полное время партии не обязано уменьшиться втрое. Для применения пересобрать и загрузить arm_calibration в WROOM с обновлённой библиотекой `libraries/SorterCore`: в ней допустимая скорость увеличена до 300 мкс/с. В HELP должно появиться `rate 300 us/s`. Прежнее подтверждение работы относится к 100 мкс/с; результат на реальной руке при 300 мкс/с ещё не получен.

При `REFUSED ARM` с `error=CONFIG_NOT_CONFIRMED` после увеличения скорости проверить также установленную копию `Documents/Arduino/libraries/SorterCore/src/ManualJogCore.h`: в проверке конфигурации должно быть `s_.rateUsPerSecond > 300`, а не `> 100`. Обновление библиотеки только в папке проекта не обновляет копию Arduino IDE. Обнаруженная старая установленная копия исправлена; для применения нужна повторная сборка и загрузка arm_calibration. Подтверждение SUPPORTED расходуется при попытке ARM; после устранения причины выполнять обычную последовательность запуска из известной физической позы.

**Принятый вариант: боковой заход +Y на 25 мм. Пользователь подтвердил: «Все. работает. Оставляй».** В arm_calibration команды SORT и CHECKPICK сначала подводят захват к (X,Y−25) на верхнем уровне, опускают там, затем перемещают открытый захват к (X,Y) по нижней карте. Детали должны находиться при X=20…130, Y=50…80 мм. После закрытия выполняется подъём у детали. Пользователь сообщил, что при прежнем отступе 15 мм рука всё равно упёрлась. Отступ 25 мм для кубика размером 30 мм задаёт начало на 10 мм перед ближней гранью. Пользователь подтвердил работу этого варианта; координаты и число выполненных переносов не сообщены. Подробности — в начале `firmware/arm_calibration/README.md`. Настройка сохранена; для её принятия повторная прошивка не требуется.

**История до принятия бокового захода 25 мм: неудачный захват SORT от 12.10.2026.** Пользователь сообщил, что у обоих кубиков рука ушла примерно на 10 мм вперёд и прижала их сверху. Уточнено направление +Y. После неудачного захвата пользователь сам передвинул кубик: уменьшение числа объектов и SORT_PICK_DONE не подтверждают физический перенос и не доказывают ошибку камеры. Момент появления смещения пока неизвестен. Результат записан в `measurements/commissioning/stage17_result.json`. После этой неудачи изменён способ подхода; работу варианта с отступом 25 мм пользователь впоследствии подтвердил. Программные проверки не подтверждают физическую точность захвата.

## Принятый боковой заход на 25 мм

Сборка для WROOM на Arduino ESP32 3.3.12 и программные проверки нового подхода прошли. Пользователь подтвердил работу бокового захода 25 мм и попросил оставить настройку. Агент платой не управлял; координаты и число успешных переносов в подтверждении не указаны.

В `LocalConfig.h` задано `SIDE_APPROACH_MM = 25` по последнему запросу пользователя. Это расстояние **от центра захвата до центра детали по Y**, без добавления половины кубика. Камера передаёт центр детали; например, для X=115, Y=60 точка начала опускания будет X=115, Y=35 мм. Это общий отступ 25 мм от центра детали, а не дополнительные 25 мм к прежним 15 мм.

Последовательность SORT теперь такая:

1. HUB, затем **SIDE_HIGH** над (X,Y−25), номинальная высота около 100 мм.
2. **SIDE_LOW** в той же точке (X,Y−25), номинальная высота нижней части пальцев 10 мм, захват открыт.
3. **ENTER_Y** к центру детали (X,Y) на нижнем уровне. В карте меняется Y, X остаётся заданным; реальный путь между импульсами может иметь отклонения X/Z.
4. **GRIP** закрывает захват до 1250 мкс. Затем LIFT_NEAR/LIFT поднимают деталь у места захвата, после чего выполняются HUB, выбранный по цвету контейнер и возврат PARK. Обратного перемещения на 25 мм с грузом на нижнем уровне нет.

Центр детали должен быть в X=20…130, Y=50…80 мм: для меньшего Y точка Y−25 выходит за измеренную карту. Координаты не обрезаются и не экстраполируются. При таком случае `SIDE_APPROACH_OUTSIDE_AREA` возникает до движения. Для остальных деталей проверяется расстояние от их центров до отрезка бокового входа: менее 30 мм даёт `SIDE_PATH_BLOCKED`. Это фильтр по координатам центров, не измеритель полного объёма руки и не доказательство свободного прохода. Предыдущие проверки цветов, расстояния между центрами, изменений сцены, таймеров и остановок сохраняются.

Кубик имеет размер 30 мм вдоль Y. Пользователь сообщил об упоре при отступе 15 мм; точное место и фаза контакта не указаны. Отступ увеличен до 25 мм: номинальная точка начала на 10 мм перед ближней гранью кубика. После изменения пользователь подтвердил работу варианта с отступом 25 мм. Это наблюдение принятого опыта; всю область карты оно отдельно не проверяет. Общая поправка координат и компенсация ошибки всей карты не вводились. Прежняя цель Y=46 мм теперь вне допустимой области бокового подхода: её точка начала Y=21 мм выходит за карту. Переставить кубик, например, на Y=60 мм.

Следующий порядок сохранён для повторной загрузки и нового сеанса; после подтверждённого успешного опыта повторять прошивку не требуется. При необходимости загрузить **arm_calibration в WROOM** со всеми соседними заголовками. Перед прошивкой поддержать руку, выполнить DISARM, выключить питание приводов. Если физически сохранён PARK 1500,1200,1500,2100, после загрузки отправить SEED с этими значениями, SUPPORTED; включить питание и ENABLE32, затем ARM и дождаться HOLDING. Если звенья сместились, сначала восстановить известную позу; SEED не перемещает и не измеряет руку.

Для наблюдения новой траектории служит прежняя команда **CHECKPICK**, но имена остановок изменились: **SIDE_HIGH → SIDE_LOW → TARGET_LOW**. Оставить один кубик и отметить центр. CHECKPICK снимает кадр из PARK, идёт в SIDE_HIGH и ждёт. В этой остановке убрать кубик, сохранив метку; отдельный NEXT опускает в SIDE_LOW, следующий NEXT подводит к TARGET_LOW. Захват не закрывается. BACK возвращает по достигнутым точкам и через HUB в PARK. Таким способом можно наблюдать опускание до запуска SORT с кубиком. В паузе до 5 минут, POSE/HOLD продлевают ожидание; весь CHECKPICK до 15 минут, сессия ARM до 30 минут.

Для реального SORT после проверки прохода поставить один кубик, например X=115, Y=60 мм, и отправить SORT из удерживаемой PARK. Начало опускания будет Y=35 мм. При попадании в свой контейнер следующий запуск может содержать два кубика примерно X=40/Y60 и X=100/Y60. Детали не двигать руками между снимками одной партии. Если при опускании захват снова касается кубика сверху, остановить ESTOP/ENABLE: это означает, что выбранного отступа недостаточно для фактического пути. В конце поддержать PARK, DISARM, выключить питание приводов.

В журнале будут `SORT_APPROACH ... distance_mm=25 direction=+Y` и `SORT_STEP ... name=SIDE_HIGH`, `SIDE_LOW`, `ENTER_Y`. Изменение координатной карты проверяется отдельно; сообщение об исчезновении детали не заменяет наблюдение её попадания в контейнер.

## История: выполненная местная поправка для точки 115,4 / 42,3 мм

CHECKPICK выполнен пользователем в этой точке. Фактические замеры HIGH = 115/47/101 мм, NEAR = 122/58/30 мм, LOW = 120/48/8 мм. Отклонение Y составляет соответственно +4,7 / +15,7 / +5,7 мм: единая поправка −10 мм не подходит для всего опускания. Наибольшее из трёх измеренных отклонений — в NEAR, где нижний край пальцев лишь на 3 мм выше детали высотой 27 мм. Точное место столкновения и максимум ошибки между остановками не измерены. Запись — `measurements/commissioning/stage17_checkpick_001.json`.

Подготовлена первая **расчётная проба только для этой точки**: для каждого уровня координаты запроса карты уменьшены на наблюдаемое отклонение X/Y. Это местное приближение, требующее замера. Оно не исправляет высоту Z независимо и не подтверждает точность других мест стола. Импульсы остаются в существующих пределах; прошивка и глобальная карта SORT пока не меняются. Новая прошивка для пробы не нужна.

1. Если CHECKPICK ещё стоит в PAUSED, отправить BACK и дождаться CHECK_RESULT с возвратом в PARK. Если уже удерживается PARK после BACK, повторять его не надо. Следующие MOVE выполняются только из удерживаемой PARK с включённой прежней сессией. Если сессия истекла и звенья сместились, сначала восстановить известную стартовую позу; расчётные команды ниже не являются SEED фактической руки.
2. Кубик убрать. Сохранить прежнюю пустую метку центра в X=115,4, Y=42,3 мм. Отправить `MOVE 1500,1500,1500,2100`, дождаться HOLDING в HUB.
3. Отправлять **по одной команде**, ждать HOLDING, затем записывать фактические X/Y/Z:

| Поза | Команда | Что записать |
|---|---|---|
| HIGH | `MOVE 1267,1405,1252,2100` | Проекция середины губок X/Y и высота нижней части пальцев Z |
| NEAR | `MOVE 1266,1874,658,2100` | Те же три координаты после остановки |
| LOW | `MOVE 1260,2032,574,2100` | Те же три координаты после остановки |

4. Все три X/Y должны приблизиться к прежней метке 115,4/42,3. Это ожидаемый эффект расчёта, а не уже измеренный результат. При касании стола или упоре остановить ESTOP/ENABLE и поддержать руку; не продолжать ради полного списка.
5. Если проход завершён без касаний, вернуться по пройденным позам: `MOVE 1266,1874,658,2100` → `MOVE 1267,1405,1252,2100` → `MOVE 1500,1500,1500,2100` → `MOVE 1500,1200,1500,2100`. Каждую команду вводить отдельно после HOLDING. Здесь CHECKPICK уже завершён, поэтому BACK не заменяет эту ручную последовательность.
6. Прислать HIGH, NEAR, LOW с фактическими X/Y/Z одним сообщением. После возврата установить опору, DISARM и отключить питание приводов. Не запускать SORT и не копировать эти абсолютные позы к другим координатам до проверки результата.

## Справка: исходное измерение CHECKPICK с остановками

Сборка CHECKPICK для WROOM на Arduino ESP32 3.3.12 прошла. Программно проверены паузы, явное продолжение, возврат, открытый захват, таймеры и остановки; физическая точность этим не подтверждается.

Команда **CHECKPICK** использует те же HIGH, NEAR и LOW, что SORT, но останавливается в каждой из этих поз. Захват остаётся открытым при 2100 мкс. Переход вниз разрешает только отдельная команда NEXT; автоматического захвата, переноса в контейнер и второй фотографии нет. Карта не исправлена предположительной поправкой −10 мм: нужны реальные координаты хотя бы в одном месте промаха.

1. Загрузить обновлённую `arm_calibration.ino` со всеми соседними заголовками **только в WROOM**; камера и подключение прежние. Перед загрузкой поддержать руку, DISARM, отключить питание приводов. Для запуска нужна физически сохранённая поддерживаемая PARK 1500,1200,1500,2100. Если рука после остановки сместилась, не выдавать эти числа за текущую позу через SEED: сначала восстановить известное положение. Монитор 115200, новая строка.
2. Из сохранённой PARK: `SEED 1500,1200,1500,2100`, `SUPPORTED`; включить питание приводов и ENABLE32, затем `ARM`. Дождаться HOLDING, убрать мешающую опору.
3. Оставить один синий кубик около прежнего места X=112,6, Y=34 мм. **До движения отметить на столе его центр**, сохраняя прежнюю разметку и ориентацию. Красный кубик убрать. Отправить `CHECKPICK`. В журнале появятся CHECK_TARGET и три CHECK_PLAN с рассчитанными импульсами. Если камера снова выдаст ровно 112,6/34,0 мм, расчёт даст HIGH 1277,1376,1241,2100; NEAR 1254,1895,694,2100; LOW 1248,2025,557,2100. Это прогноз команд, не замер и не значения для SEED.
4. Дождаться **CHECKPOINT name=HIGH** и `trial=PAUSED`. Рука удерживается над целью; PARK — другая поза, здесь оценивается именно положение над кубиком. Записать фактические X/Y проекции середины между губками на стол и Z нижней части пальцев над столом. Затем аккуратно убрать кубик из-под неподвижного захвата, оставив метку. **Дальнейшее опускание выполнять над пустой меткой**, чтобы исключить повторное прижатие кубика.
5. Отправить `NEXT` один раз. Дождаться **CHECKPOINT name=NEAR**, записать X/Y/Z. Ещё один `NEXT` — **CHECKPOINT name=LOW**, снова записать X/Y/Z. Это три замера за один сеанс, без подбора JOG после каждого ответа в чате. Высота NEAR не задана в миллиметрах: она получена усреднением импульсов. Для HIGH ожидается около 100 мм, LOW около 10 мм, но фактическую Z надо измерить, а не переписать прогноз.
6. Из любой остановки HIGH/NEAR/LOW можно отправить `BACK`: рука проходит уже достигнутые точки в обратном порядке, затем HUB и PARK. При нормальном завершении выводится `CHECK_RESULT returned_park_command=1 gripper_open=1`. После LOW команда NEXT отказывается продолжать: захват не закрывается. При неожиданном касании стола или упоре остановить ESTOP/ENABLE и поддержать руку; не продолжать движение ради замера.
7. Прислать CHECK_TARGET, три CHECKPOINT и фактические X/Y/Z для HIGH, NEAR, LOW. После возврата поддержать PARK, DISARM, отключить питание приводов. Если опускание пришлось остановить, прислать только достигнутые точки и причину; полный проход не обязателен.

В паузах есть до 5 минут без принятой команды, POSE/HOLD/STATUS продлевают только это ожидание. CHECKPICK ограничен 15 минутами, вся сессия ARM — 30 минутами. NEXT и BACK принимаются **только при PAUSED**, во время движения отказываются без очереди. Не вставлять несколько NEXT одним блоком. MOVE/JOG/SORT/AIMRED/TRIALRED блокируются до завершения CHECKPICK; DISARM/ESTOP/RESET отменяют его, восстановление разрешения движения не перезапускает опыт. Программа не умеет определять, убран ли кубик: оператор убирает его в HIGH перед NEXT.

Эта прошивка позволяет двигать собранную MeArm вручную и записывать положения для будущей сортировки. JOG меняет один привод, остальные удерживаются; MOVE плавно переводит все четыре канала к заданной абсолютной позе. TRIALRED использует камеру для одного фиксированного красного переноса. AIMRED подводит открытый захват над координатами красной детали по верхней карте. SORT выполняет ограниченную партию красных и синих деталей по координатам камеры с проверкой кадра после каждого переноса.

В текущем `LocalConfig.h` три разрешения уже включены пользователем: `OUTPUTS_ENABLED`, `PINOUT_CONFIRMED`, `LIMITS_CONFIRMED` равны `true`. Это сохранено. При включении платы рука всё равно не запускается сама: нужны `SEED`, `SUPPORTED`, `ARM`. Перед загрузкой проверить эти настройки и свободный ход механики.

Пользователь сообщил результаты отдельных проверок: основание свободно 500–2500 мкс, плечо 800–2200 мкс, второй рычаг 600–1700 мкс. При снятии карты отдельно подтверждены две нижние позы с каналом 2 = 500 мкс; пользователь изменил его MIN_US на 500. Это подтверждение именно этих поз, а не всего диапазона при любых сочетаниях связанных звеньев. Захват открывается при 2100 мкс, пустые губки впервые касаются при 900 мкс, нынешняя деталь удерживается при 1250 мкс.

Рабочие границы с запасом уже внесены в `LocalConfig.h`:

| Канал | Наблюдение пользователя, мкс | Текущий рабочий диапазон, мкс |
|---|---|---|
| 0 — основание | 500–2500 свободно | 550–2450 |
| 1 — плечо | 800–2200 свободно | 850–2150 |
| 2 — второй рычаг | Ранее 600–1700; отдельно две нижние позы при 500 | 500–1650 |
| 3 — захват | Открыто 2100; пустой контакт 900; деталь 1250 | 950–2100 |

Для основания и плеча оставлен запас 50 мкс с каждой стороны; для рычага верхняя граница 1650 сохранена, нижняя по двум проверенным позам изменена на 500. Захват не закрывается до пустого контакта 900: рабочий минимум 950; открытая команда 2100 сохранена. Пользователь подтвердил повторяемый захват нынешней детали при **1250 мкс**; число выполненных повторов не сообщено. Для других размеров и форм команда ещё требует проверки. В текущей конфигурации возврат к поисковому окну 500–2500 для всех каналов не нужен.

## Этап 17: порядок SORT после устранения промаха

Этап 16 завершён в одной точке: пользователь прислал `AIM_TARGET x_mm=41.6 y_mm=70.1 predicted_z_mm=99.6 command_us=1537,1601,1303,2100` и подтвердил «все совпало». Это наблюдение совпадения центров сверху; фактическая Z и нижняя поза этим не измерены. Результат сохранён в `measurements/commissioning/stage16_result.json`. Этап 15 ранее завершился попаданием красной детали в контейнер без проблем.

Теперь в **arm_calibration** используется команда **SORT**: свежий снимок из PARK, наведение по координатам, захват, выбор красного или синего контейнера, возврат в PARK и следующий снимок. Каждая деталь проходит 14 поз; открытый захват — 2100 мкс, удержание нынешнего кубика — 1250 мкс. Камера, проводка и положение контейнеров прежние. Основная motion_node остаётся виртуальной; нижний центр и XYZ PARK не подменяются расчётами.

1. Если рука после AIMRED ещё удерживается над кубиком, вернуть её командами `MOVE 1500,1500,1500,2100`, затем `MOVE 1500,1200,1500,2100`. После каждой дождаться HOLDING и наблюдать свободный ход. Если она уже в PARK, эти перемещения пропустить. Поддержать PARK, DISARM, выключить силовые 5 В и загрузить обновлённую **arm_calibration только в WROOM**. Монитор — 115200, «Новая строка». Сборка SORT на Arduino ESP32 3.3.12 и программные проверки прошли; последующее физическое испытание выявило промах при захвате обоих кубиков, см. актуальный результат в начале документа.
2. При физически сохранённом PARK отправить `SEED 1500,1200,1500,2100`, `SUPPORTED`; включить 5 В и ENABLE32, затем `ARM`, дождаться HOLDING. SEED сообщает нынешнюю позу и сам руку не перемещает. После устойчивого удержания убрать мешающую опору.
3. После проверки свободного бокового захода поставить два одинаковых по размеру кубика: красный примерно **X40/Y60**, синий **X100/Y60 мм**. Центры должны быть в **X=20…130, Y=50…80 мм**; расстояние между любыми двумя центрами не меньше **30 мм**, лучше 40 мм. Убрать руки из зоны и отправить `SORT` один раз. Контейнер 1 — красный, контейнер 2 — синий.
4. До конца партии не добавлять и не убирать детали вручную. После каждого переноса программа возвращается в PARK, ждёт 800 мс и получает новый кадр. Проверяется исчезновение прежней цели в радиусе 8 мм, уменьшение числа деталей выбранного цвета ровно на одну и неизменное число другого цвета. Ошибка останавливает партию без повторного захвата.
5. При успехе ожидается `SORT_RESULT sorted=2 red=1 blue=1 returned_park_command=1; confirm bins by observation.` и state=HOLDING, trial=DONE, camera_action=SORT. Посмотреть, действительно ли обе детали внутри своих контейнеров. Командный результат сам этого не измеряет.
6. Если партия прошла без зацепов, гудения и промахов, повторить три партии по два кубика в (40,60) и (100,60) мм, меняя цвета местами. Из удерживаемого PARK снова отправлять `SORT`; сохранить каждую строку SORT_RESULT, ожидается sorted=2, red=1, blue=1. Детали перекладывать только между завершёнными партиями. Прежняя раскладка в два ряда с Y=35 мм для отступа 25 мм не подходит.
7. После завершения поддержать PARK, отправить DISARM и выключить силовые 5 В. Записать число доставленных в правильные контейнеры, промахов и время каждой партии; снять видео полного цикла для защиты.

За один запуск разрешены максимум 8 попыток переноса (sortAttempts) и 15 минут; ответ камеры ожидается 6 секунд. Лимит партии не отменяет абсолютные 30 минут ручной сессии. SORT, AIMRED и TRIALRED взаимно исключены. Ошибки `OBJECT_OUTSIDE_SORT_AREA`, `PARTS_TOO_CLOSE`, `TARGET_STILL_PRESENT`, `SCENE_CHANGED_UNEXPECTEDLY`, `SORT_ROUTE_INVALID`, `BATCH_TIME_LIMIT`, `CAMERA_TIMEOUT` требуют остановки и устранения причины, не автоматического повторения. При касании или сильном гудении — ESTOP либо разомкнуть ENABLE32. При выключении силовых 5 В выполнить DISARM до восстановления питания.

Это объединённое заключительное испытание стенда под наблюдением. Верхняя карта использует измеренный центр, нижняя — измеренные углы и интерполяцию между ними. Точный захват всей области, синий маршрут и повторяемость партии сейчас проверяются; нижний центр и XYZ PARK остаются неизвестны. Флаги geometry/routes/parkSupported основной motion_node не включаются. Не менять конфигурацию ради этого этапа: в arm_calibration сохранены подтверждённые выходы, распиновка и пределы. Соседние файлы прошивки должны загружаться вместе со скетчем.

### Команды запуска и результат

После загрузки, при выключенных силовых 5 В и физически сохранённом поддерживаемом PARK:

```text
SEED 1500,1200,1500,2100
SUPPORTED
```

Включить 5 В сервоприводов и ENABLE32, затем:

```text
ARM
```

После HOLDING и размещения партии:

```text
SORT
```

Не отправлять MOVE/JOG/AIMRED/TRIALRED в ходе партии. STATUS, POSE и HOLD можно использовать для наблюдения и продления удержания; они не запускают дополнительные перемещения. Для следующей партии из PARK достаточно новой команды SORT. Полная ручная сессия ограничена 30 минутами: её окончание не снимается лимитом партии.

Успешный конец двухцветной партии:

```text
SORT_RESULT sorted=2 red=1 blue=1 returned_park_command=1; confirm bins by observation.
```

Здесь sorted — число переносов с подтверждённым изменением кадра; red/blue — их распределение по классу. Проверка кадра не определяет, упала ли деталь именно в контейнер. В DONE физические PWM продолжают удерживать PARK; перед DISARM установить опору.

Пришлите строки SORT_RESULT всех завершённых партий и кратко: сколько деталей реально внутри каждого правильного контейнера, были ли промахи, зацепы или сильное гудение. Не выдавать предполагаемую точность за измеренную; успех одной партии не заменяет статистику.

## Этап 16: завершённое наведение AIMRED — справка

Этап 16 завершён в одной точке: пользователь прислал `AIM_TARGET x_mm=41.6 y_mm=70.1 predicted_z_mm=99.6 command_us=1537,1601,1303,2100` и подтвердил «все совпало». Это наблюдение совпадения центров сверху; фактическая Z и нижняя поза этим не измерены. Результат сохранён в `measurements/commissioning/stage16_result.json`. Этап 15 ранее завершился попаданием красной детали в контейнер без проблем.

AIMRED остаётся отдельной командой: один красный объект, один снимок из PARK, переход через HUB к верхней позе с открытым захватом, затем HOLDING. Спуска и переноса она не выполняет. При текущем этапе повторять одиночную проверку AIMRED не требуется.

## Этап 15: завершённый реальный красный перенос — справочный порядок TRIALRED

Пользователь подтвердил успешный результат, приведённый выше. Ниже сохранена последовательность выполненного этапа; для SORT повторять TRIALRED не требуется. Поля STATUS ниже описывают ожидаемый формат, полученным логом является только строка TRIAL_RESULT.

Этапы 11 и 12 выполнены по сообщениям пользователя: захват, удержание и возврат, затем доставка в красный контейнер без проблем. Камера и UART также работают. Полученный итог этапа 14 — DONE, error=NONE, attempts=2, cleared=2, physical_pwm=0, seq=3, stale=0, batch_limit_ms=900000 — подтверждает виртуальный цикл с двумя деталями; это история прежнего профиля. Теперь по просьбе пользователя **PARK = 1500,1200,1500,2100 мкс** — исходная поза, положение обоих снимков и возврат TRIALRED. Прежняя HIGH **1600,1700,1350,2100** остаётся подходом над 20/80. Её физическое положение и CAMSCAN одной красной на 20/80 ранее подтверждены пользователем, сырого OBJECT не было. В выполненном этапе TRIALRED проверяла count/color/±15 мм из нового PARK.

### 1. Подключение и загрузка

Если прежняя arm_calibration сейчас действительно удерживает подтверждённую HIGH 1600,1700,1350,2100, перед загрузкой отправить по одной команде, наблюдая свободный ход и ожидая **HOLDING** после каждой:

```text
MOVE 1500,1500,1500,2100
MOVE 1500,1200,1500,2100
```

Первая команда ведёт в HUB, вторая меняет только плечо на −300 мкс до нового PARK. Это плавные команды приводам, не поиск нуля и не обещание прямого пути губок. При касании/упоре остановить. Если уже удерживается физически известный новый PARK, этот переход пропустить. Если рука DISARMED или сместилась, не считать прежний виртуальный STATUS её фактическим положением и не ARM по слепому SEED: нужна известная поддерживаемая исходная поза.

Поддержать **новый PARK** на опоре, выполнить DISARM и выключить силовые 5 В SG90. Не дать звеньям сместиться при загрузке. Перепрошить **только WROOM новой `firmware/arm_calibration/arm_calibration.ino`**; рядом с ней должен оставаться файл RedPickTrial.h из проекта. Камера уже актуальна и не перепрошивается. Обновлённая версия с PARK собрана на Arduino ESP32 3.3.12 и проверена программно; агент плату не прошивал и приводы не запускал. USB-монитор WROOM — **115200 бод**, окончание строки «Новая строка».

| Подключение | Как оставить |
|---|---|
| SG90: основание / плечо / второй рычаг / захват | Сигналы GPIO25 / 26 / 27 / 33 напрямую; от каждого сигнала один 10 кОм к общей GND |
| Питание приводов | Отдельные 5 В; ESP32 питается от USB, земля общая |
| ENABLE | Переключатель GPIO32 → 3V3; GPIO23/34 не подключены |
| Камера → WROOM | TX13 → RX16 |
| WROOM → камера | TX17 → RX14; UART 115200, уровни 3,3 В, общая GND |

У камеры GPIO13/14 заняты UART, microSD не используется. Плюсовые линии разных источников питания не объединять. Камера, основание, контейнер, разметка, освещение, цвета и calibration_id=1573755510 сохраняются.

В arm_calibration разрешения OUTPUTS_ENABLED/PINOUT_CONFIRMED/LIMITS_CONFIRMED уже true, CAMERA_UART_CONFIRMED=true. Границы каналов остаются 550–2450, 850–2150, 500–1650, 950–2100 мкс, скорость 300 мкс/с. Ничего переключать в основной motion_node не нужно: её виртуальный режим, выключенные аппаратные выходы и geometry/routes/parkSupported=false сохраняются.

### 2. Запустить удержание из сохранённого PARK

При пока отключённых силовых 5 В, физически сохранённом PARK и опоре отправить по одной строке:

```text
SEED 1500,1200,1500,2100
SUPPORTED
```

Затем включить внешние 5 В SG90, замкнуть ENABLE32 на 3V3 и отправить:

```text
ARM
STATUS
```

Ожидаются **state=HOLDING, outputs=1, command_us=1500,1200,1500,2100, camera_uart=1**. Только после устойчивого удержания убрать опору, если она мешает движению, и руки из рабочей зоны. Если физическая поза сместилась, этот SEED не восстанавливает её плавно: не ARM вслепую. PARK задаётся четырьмя известными импульсами, а не общей командой 1500 для всех каналов.

### 3. Поставить одну красную деталь и отправить одну команду

Использовать ту же лёгкую деталь, форму и ориентацию, с которыми выполнен ручной красный перенос. Ориентир для центра — **X=20, Y=80 мм**; программа допускает **X=5…35 мм и Y=65…95 мм включительно**. Успешный захват при смещении ещё не проверен. Других деталей в поле камеры быть не должно; красный контейнер остаётся на своём месте. Убрать руку из кадра и отправить:

```text
TRIALRED
```

Камера сначала должна обнаружить ровно одну красную деталь с центром не дальше **±15 мм по каждой оси** от отметки. Это фильтр входных координат, а не проверенная область захвата вокруг точки. Рука всё равно берёт по фиксированным ранее проверенным командам 20/80, без интерполяции карты. Деталь должна целиком помещаться в видимую откалиброванную область камеры: выход за её край по-прежнему исключает объект из ответа. В TRIAL_TARGET теперь выводится tolerance_mm=15.0.

Первый снимок выполняется из PARK. После принятого снимка программа сама проходит **14 поз**: HUB_OUT → APPROACH_HIGH над 20/80 → NEAR → LOW → закрытие 1250 → NEAR с деталью → HIGH → HUB → HIGH красного контейнера → DROP → открытие 2100 → HIGH контейнера → HUB_RETURN → PARK_RETURN. Текущая заданная скорость 300 мкс/с; движение согласуется по импульсам всех каналов, путь губок не обязан быть прямым. Дополнительные MOVE/JOG и запросы камеры во время TRIALRED не отправлять. **SIM_REMOVE здесь не используется: деталь переносит рука, оператор её не убирает.** Автоматической второй попытки нет.

Наблюдать захват, просвет всей детали над бортом, отпускание внутри контейнера и возврат. При касании, упоре, сползании или сильном гудении остановить ESTOP/размыканием ENABLE32 и поддержать руку; при механическом упоре физически отключить силовые 5 В. Не продолжать автоматически из места остановки.

### 4. Ожидаемые ответы и завершение

Сначала появляются TRIAL_SCAN phase=WAIT_CAMERA, TRIAL_SCENE count=1 и TRIAL_TARGET color=red bin=1 с реальными координатами. Затем TRIAL_STEP 1/14 name=HUB_OUT … TRIAL_STEP 14/14 name=PARK_RETURN. После возврата в PARK и выдержки **800 мс** выполняется новый настоящий снимок, ожидаются:

```text
TRIAL_SCENE count=0 calibrationId=1573755510 boot=...
TRIAL_RESULT scene_cleared=1 returned_park_command=1; confirm the part is inside the red bin by observation.
```

Многоточие обозначает формат camera_boot, а не полученный лог. После ответа отправить STATUS: **state=HOLDING, outputs=1, command_us=1500,1200,1500,2100, camera_uart=1, trial=DONE, trial_error=NONE**. returned_park_command подтверждает завершение командного движения, а не измерение положения SG90; scene_cleared — пустой кадр, а не попадание в контейнер. Это проверить глазами.

Рука в конце продолжает удерживать **PARK**, автоматического DISARM нет. Поддержать её на опоре, отправить **DISARM**, затем выключить силовые 5 В. Ожидание между командами 5 минут, ручная сессия 30 минут; STATUS/POSE продлевают только ожидание. На ответы камеры отведено 6 секунд, на сам однократный опыт — 3 минуты.

| Сообщение | Что означает |
|---|---|
| TRIAL_REFUSED reason=ARM_IN_HOLDING_REQUIRED / START_PARK_REQUIRED | Нет удержания или командная поза отличается от нового PARK; не исправлять слепым SEED |
| TRIAL_FAILED reason=ONE_RED_PART_REQUIRED | Камера видит не ровно одну красную деталь; перенос не начат |
| TRIAL_FAILED reason=PART_OUTSIDE_TRIAL_POINT | Измеренный центр вне ±15 мм по X/Y; перенос не начат |
| TRIAL_FAILED reason=SCENE_NOT_EMPTY_AFTER_TRANSFER | После возврата камера всё ещё видит объект; второго захвата не будет |
| TRIAL_FAILED reason=CAMERA_TIMEOUT / CAMERA_RESTART | Нет подходящего ответа за 6 секунд либо камера перезапустилась |

**Сообщить:** взял ли деталь, отпустил ли внутри красного контейнера, вернулся ли в PARK, были ли проблемы; скопировать TRIAL_RESULT и итоговый STATUS, а при отказе — TRIAL_FAILED/TRIAL_REFUSED. Новые XYZ для этого опыта не требуются. XYZ нового PARK пока не измерены: в карте сохранены только его импульсы, measured_ok=false; виртуальные координаты профиля не являются замером. Этап 15 подтверждён пользователем; успех одного маршрута не подтверждает всё поле, синий контейнер или нижний центр и не включает основную аппаратную сортировку. Старые ручные этапы 11/12 ниже сохранены со своей прежней HIGH, их команды не заменялись новым PARK.

## Этап 12: завершённый красный перенос, справочный порядок

Пользователь подтвердил один успешный функциональный опыт этапа 11: деталь взята, поднята, удержана 5 секунд, возвращена и отпущена, проблем нет. Новых координат не сообщал. Результат записывается в `measurements/mearm_setup/functional_tests.csv`; 11 численных контрольных проб остаются в `pose_repeatability.csv`.

В выполненном этапе 12 использовалась **arm_calibration с MOVE** без новой загрузки, изменения библиотеки или проводки. GPIO25/26/27/33, четыре резистора 10 кОм к общей GND, внешние 5 В, USB ESP32 и ENABLE32 остаются прежними. Камера тогда не участвовала, автоматическая motion_node остаётся виртуальной с выключенными выходами и допусками. Пользователь подтвердил доставку в красный, отпускание внутри и возврат без проблем; синий контейнер этим не проверен. Ниже сохранён выполненный порядок; для этапа 15 не повторять его вручную, его один раз выполнит TRIALRED.

### 1. Продолжить или возобновить ручную сессию

Открыть монитор 115200 бод, окончание строки «Новая строка». Отправить STATUS. Если рука уже в HOLDING, продолжать таблицей пустого прохода: нового ARM не требуется. MOVE — абсолютная команда; текущую удерживаемую команду сохраняет работающий контроллер.

Если состояние DISARMED, использовать следующий запуск **только если рука физически сохранила известную HIGH-позу на опоре** после последнего шага этапа 11:

```text
SEED 1600,1700,1350,2100
SUPPORTED
ARM
```

Ожидаются HOLDING и outputs=1. Эта HIGH-поза была последним предписанным шагом этапа 11, но отдельного нового POSE от пользователя не было. Если при снятии PWM звенья сместились, числа не доказывают фактическую позу: сначала восстановить физически известное поддерживаемое положение. Не ARM вслепую и не подставлять общие 1500. SEED не выполняет плавного подхода или поиска нуля.

Отправлять **по одной строке**, после каждой ждать HOLDING. Очереди нет. MOVE плавно меняет четыре импульса с общим прогрессом до 300 мкс/с, а путь губок не обязан быть прямым. На ввод 5 минут, сессия 30 минут; STATUS/POSE в HOLDING продлевают ожидание, но не общий срок. В конце поддержать руку и DISARM. ESTOP или размыкание ENABLE32 снимают PWM; при упоре или сильном гудении поддержать и сразу физически отключить питание.

### 2. Пройти новый путь без детали

Закрепить красный контейнер в прежнем измеренном месте. Его HIGH и DROP взяты из текущей карты; это известные команды конечных поз, не доказательство свободного пути между ними. Убрать деталь из захвата. Не снимать XYZ после каждой строки: наблюдать всю руку, провода, пальцы и борт. Если свободного прохода нет, не продолжать к опыту с деталью.

| Команда, после каждой ждать HOLDING | Участок |
|---|---|
| `MOVE 1600,1700,1350,2100` | HIGH над проверенным углом 20/80 |
| `MOVE 1500,1500,1500,2100` | HUB |
| `MOVE 2100,1600,850,2100` | HIGH красного контейнера |
| `MOVE 2100,1800,750,2100` | DROP красного контейнера |
| `MOVE 2100,1600,850,2100` | Назад в HIGH контейнера |
| `MOVE 1500,1500,1500,2100` | Назад через HUB |
| `MOVE 1600,1700,1350,2100` | Назад в HIGH над 20/80 |

### 3. Перенести одну красную деталь

Поставить одну лёгкую красную деталь центром на X=20, Y=80 в прежних осях; для квадратной детали выбрать положение между губками без перекоса. Начать из HIGH после пустого прохода. Закрытие 1250 уже использовалось в успешном захвате; не усиливать сжатие при упоре. Во время переноса следить за удержанием и просветом **всей детали**, особенно части ниже пальцев и над бортом контейнера. Свободный пустой проход не подтверждает проход с грузом.

| Команда или действие, ждать HOLDING после каждого MOVE | Действие |
|---|---|
| `MOVE 1600,2060,950,2100` | Подойти через прежнюю промежуточную команду |
| `MOVE 1600,2150,850,2100` | Открытые губки в LOW у детали |
| `MOVE 1600,2150,850,1250` | Захватить |
| `MOVE 1600,2060,950,1250` | Начальный подъём с деталью |
| `MOVE 1600,1700,1350,1250` | HIGH с удержанием |
| `MOVE 1500,1500,1500,1250` | Через HUB с удержанием |
| `MOVE 2100,1600,850,1250` | Над красным контейнером |
| `MOVE 2100,1800,750,1250` | Опуститься к DROP |
| После HOLDING подождать **1 секунду** | Дождаться устойчивого положения перед открытием |
| `MOVE 2100,1800,750,2100` | Открыть внутри контейнера |
| `MOVE 2100,1600,850,2100` | Подняться с открытым захватом |
| `MOVE 1500,1500,1500,2100` | Обратно через HUB |
| `MOVE 1600,1700,1350,2100` | Вернуться в HIGH над 20/80 |

**Сообщить результат:** доставил ли в красный контейнер, отпустил ли внутри, вернулся ли в HIGH, были ли сползание, касания, упор или гудение. Новые XYZ для этого функционального этапа не требуются. Результат фиксировать в functional_tests.csv по фактическому наблюдению. Даже успешный один перенос не подтверждает синий контейнер, всё поле, нижний центр, PARK или все автоматические маршруты. Их флаги остаются false.

## Этап 11: завершённый первый захват, справочный порядок

Исходная подтверждённая поза перед этапом 11 — **1441,1466,1195,2100 мкс**, реальные X=75, Y=52,5, Z=99 мм, упоров и сильного гудения нет. В журнале 11 контрольных проб, это не 11 повторов одного захвата. Верхний центр карты остаётся ранее записанным 1441/1426/1220/2100; нижний центр пока не измерен. Пользователь затем подтвердил успешный захват, подъём, удержание 5 секунд и возврат без проблем; ниже сохранён выполненный порядок. Его повторять перед этапом 12 не требуется.

### 1. Загрузить ручную версию с MOVE и сохранить текущую позу

При первом выполнении этапа 11 использовалась обновлённая **arm_calibration с MOVE**; её программные проверки и сборка прошли. Пользователь выполнил этот опыт, поэтому версия с MOVE уже используется. Следующие пункты сохраняют порядок первоначальной загрузки как справку; новой загрузки для этапа 12 не требуется. `motion_node` остаётся виртуальной, все автоматические допуски выключены.

Подключение прежнее: GPIO25/26/27/33 напрямую к четырём SG90, по 10 кОм от каждого сигнала к GND, внешние 5 В приводов, USB ESP32 и общая земля. Переключатель 3V3 → GPIO32; GPIO23/34 пустые. Камера и UART в этом ручном опыте не нужны. Сохранить прежние XY и положение основания.

1. В текущей HOLDING-сессии записать POSE, поддержать **нынешнюю физическую позу** устойчивой опорой, выполнить DISARM и выключить 5 В сервоприводов. Опора должна сохранить положение звеньев при выключенном PWM.
2. Загрузить обновлённый `firmware/arm_calibration/arm_calibration.ino` в управляющую ESP32. Три ручных разрешения и индивидуальные пределы не менять. Монитор 115200 бод, окончание строки «Новая строка». HELP должен содержать `MOVE us0,us1,us2,us3`.
3. При физически сохранённой известной позе включить внешние 5 В и ENABLE32, оставить опору. Отправлять по одной строке:

   ```text
   SEED 1441,1466,1195,2100
   SUPPORTED
   ARM
   ```

   Ожидаются HOLDING, outputs=1 и command_us=1441,1466,1195,2100. Если поза за время отключения изменилась, записанные числа не доказывают фактическое положение: не выполнять ARM вслепую и не заменять их общими 1500. Сначала обеспечить физически известную исходную позу на опоре.

`MOVE a,b,c,d` задаёт **четыре абсолютных импульса в мкс**. Все каналы плавно проходят к ним с общим прогрессом, скорость команды ограничена 300 мкс/с; задержка цикла не компенсируется большим скачком. Это не движение губок по прямой X/Y/Z и не поиск нуля. MOVE не ограничивается шагом JOG=100, но каждое число обязано находиться в индивидуальном MIN/MAX. Очереди нет: одна команда, дождаться **HOLDING**, затем следующая. Принятие выводит `MOVE_POSE from_us=... target_us=...; wait for HOLDING`.

### 2. Пройти путь без детали

Убрать предмет из точки 20/80. Отправлять строки таблицы **по одной**, после каждой ждать HOLDING. Следить за пальцами, звеньями, проводами и просветом над столом; отдельно измерять XYZ после каждого шага не требуется. Конечные позы были измерены, весь этот синхронный путь впервые проверяется без груза. При касании, упоре или сильном гудении поддержать руку и сразу физически снять питание; не продолжать следующей строкой.

| Команда | Что проверять |
|---|---|
| `MOVE 1600,1700,1350,2100` | Записанная HIGH-поза над углом 20/80, Z пальцев 100 мм |
| `MOVE 1600,2060,950,2100` | Промежуточная команда на 80 % перехода по импульсам; её XYZ и просвет не обещаются |
| `MOVE 1600,2150,850,2100` | Записанная LOW-поза 20/80, Z пальцев 10 мм; губки не касаются стола |
| `MOVE 1600,2060,950,2100` | Возврат через ту же промежуточную команду, наблюдать весь путь |
| `MOVE 1600,1700,1350,2100` | Возврат в HIGH с открытым захватом |

Если пустой проход не свободен, опыт с деталью не начинать. Успешный пустой проход относится только к этому пути и этой механике, не всей области карты.

### 3. Взять, удержать и вернуть одну деталь

Поставить **одну нынешнюю лёгкую деталь** центром на X=20, Y=80 в прежних осях. Для квадратной детали выбрать положение, позволяющее губкам захватить её без перекоса. Рука должна оставаться в HIGH после пустого прохода. Снова отправлять по одной команде и ждать HOLDING; при закрытии убедиться в устойчивом удержании без дополнительного сжатия.

| Команда или действие | Ожидаемый функциональный результат |
|---|---|
| `MOVE 1600,1700,1350,2100` | Открытый захват в HIGH |
| `MOVE 1600,2060,950,2100` | Подход через проверенный без детали промежуточный переход |
| `MOVE 1600,2150,850,2100` | Открытые губки возле детали в LOW |
| `MOVE 1600,2150,850,1250` | Закрыть до известной команды 1250; не добавлять сжатие при упоре |
| `MOVE 1600,2060,950,1250` | Пробный малый подъём с закрытыми губками; наблюдать реальный просвет детали |
| После HOLDING подождать **5 секунд** | Деталь удерживается без сползания; эту паузу отдельной командой задавать не требуется |
| `MOVE 1600,2150,850,1250` | Вернуть деталь в исходную точку |
| `MOVE 1600,2150,850,2100` | Открыть и отпустить её |
| `MOVE 1600,2060,950,2100` | Отойти с открытым захватом |
| `MOVE 1600,1700,1350,2100` | Вернуться в HIGH |

Промежуточный набор не гарантирует численную высоту подъёма; сначала её проверяют наблюдением. Если деталь не удержалась, не продолжать перенос и не усиливать захват ради числа. Проверять просвет всей детали, включая часть ниже пальцев. Камера, контейнеры и автоматические маршруты в этом опыте не используются.

**Результат этапа:** удалось взять одну деталь, удержать 5 секунд и вернуть в ту же точку. Записать успех или конкретную проблему. Этот результат не подтверждает точность всего поля, нижний центр, PARK или маршруты к контейнерам. В конце поддержать руку и выполнить DISARM. ESTOP и размыкание ENABLE32 также снимают PWM: опора нужна, поскольку звенья могут опуститься.

## Быстрая проверка: что отправить и что должно произойти

1. Это общая справка первого запуска. Ручные этапы 11/12 и виртуальный этап 14 уже выполнены. Для нынешнего этапа 17 использовать порядок SORT в начале README, а следующие примеры сейчас не выполнять. Не возвращать руку к 1500 ради примера. Установленная SorterCore обновлена; программные проверки и Arduino-сборка прошли. Для начального запуска записать POSE, поддержать руку, выполнить DISARM и выключить питание сервоприводов. Открыть обновлённый `arm_calibration.ino` в Arduino IDE, выбрать ESP32 Dev Module и порт второй ESP32, загрузить прошивку. Используется Arduino ESP32 3.3.12. При переносе на другой компьютер также обновить его библиотеку SorterCore из `sorter/libraries/SorterCore`: проверки шага и времени находятся и в библиотеке.
2. Открыть монитор на **115200 бод**, включить окончание строки **«Новая строка»**. Проверить общую землю ESP32 и источника, включить внешние 5 В приводов, замкнуть переключатель между 3V3 и GPIO32. Поддерживать руку опорой.
3. Отправить `STATUS`. Ожидаются `state=DISARMED`, `outputs=0`, `permit=1`. `power_monitor=NONE` означает, что измерения питания нет.
4. Только если все четыре узла свободны при 1500 мкс, отправлять по одной строке:

   ```text
   SEED 1500,1500,1500,1500
   SUPPORTED
   ARM
   ```

   После SEED и SUPPORTED движения нет. После ARM ожидаются `state=HOLDING`, `outputs=1` и `command_us=1500,1500,1500,1500`.
5. Проверить основание следующими командами. После каждого шага дождаться `HOLDING`; для проверки отправить `STATUS`.

   | Команда | Ожидаемый результат |
   |---|---|
   | `JOG 0 100` | Канал 0: 1500 → 1600 мкс, примерно 1 с |
   | `JOG 0 -100` | Канал 0: 1600 → 1500 мкс, примерно 1 с |
   | `POSE` | `COMMAND_POSE_US,1500,1500,1500,1500` после возврата |

   Первая принятая команда выводит `MOVE channel=0 from_us=1500 target_us=1600 delta_us=100`. После движения STATUS должен показать `HOLDING` и `command_us=1600,1500,1500,1500`. Это длительности управляющего импульса **в микросекундах, не градусы**; числам в POSE соответствует команда, а не измеренный угол.

   Если первый проход основания свободен, из 1500 можно проверить другую сторону: `JOG 0 -100` → 1400, затем `JOG 0 100` → 1500. Ждать HOLDING между строками. Не отправлять −200 одним шагом: максимум одной команды — 100 мкс.
6. Номера каналов: **0 — основание, 1 — плечо, 2 — второй рычаг, 3 — захват**. Ручной перенос этапа 12 завершён; в нынешнем этапе 17 последовательность партии выполняет SORT. Для остановки поддержать руку и отправить `DISARM`: ожидаются `DISARMED`, `outputs=0`.

На ввод теперь есть **5 минут бездействия**, вся сессия длится не более **30 минут**. В неподвижном `HOLDING` команды STATUS, HELP, POWER, POSE и HOLD снова дают 5 минут. Общий предел 30 минут они не продлевают. Не нужно торопиться с командами; руку нельзя оставлять без присмотра и опоры.

Максимальный шаг **JOG — 100 мкс**; JOG с шагом ±1000 будет отклонён. MOVE принимает абсолютную позу, поэтому переход может быть больше 100, но все целевые импульсы обязаны оставаться в индивидуальных границах таблицы выше. Например, захват с целью 900 будет отклонён при минимуме 950. Пределы одного сустава не доказывают свободный ход при любых положениях остальных.

## Подключение

При отключённом питании соединить сигналы SG90 напрямую:

| Канал | Узел MeArm | GPIO ESP32 |
|---|---|---|
| 0 | Основание | 25 |
| 1 | Плечо | 26 |
| 2 | Второй рычаг механизма | 27 |
| 3 | Захват | 33 |

Сигнальный провод обычно оранжевый или жёлтый; проверить свой привод. Все красные провода подключаются параллельно к внешним 5 В, все коричневые/чёрные — к минусу источника. Минус соединить с GND ESP32. GPIO выдаёт только управляющий сигнал и не питает мотор. ESP32 питается через свой USB; не соединять внешние 5 В с выводом 5V USB-подключённой платы. Для источника с надписью «15 Вт» проверить отдельную строку 5 В и допустимый ток на этикетке: общая мощность не определяет ток именно при 5 В.

Переключатель разрешения: `3V3 ESP32 → переключатель → GPIO32`. В прошивке включена подтяжка вниз: разомкнуто — запрещено, замкнуто — разрешено. Дополнительный резистор для этого входа не нужен. GPIO23 и GPIO34 не используются и никуда не подключаются для контроля сервоприводов.

На **каждом** сигнальном проводе SG90 оставить один резистор 10 кОм к общей земле, всего четыре резистора. GPIO соединяется с сигналом напрямую; резистор подключается ответвлением, а не последовательно:

```text
GPIO ESP32 ────────●──────── сигнал SG90
                  │
                10 кОм
                  │
                 GND
```

Резистор удерживает сигнал в LOW, когда GPIO не управляет им; напряжение питания он не измеряет. Сигналы разных приводов между собой не соединять. Последовательные резисторы и делитель питания не нужны.

Включать сначала USB ESP32 при открытом переключателе разрешения, затем питание приводов. Перед обычным выключением поддержать звенья и выполнить DISARM, затем выключить питание приводов и ESP32.

Переключатель GPIO32 — программный вход разрешения, а не независимое отключение питания. Отдельный выключатель или доступный разъём физически отключает питание всех приводов. Поддерживать звенья опорой, поскольку снятие PWM не гарантирует удержание руки.

## Проверка перед первым ARM

До ARM выходы выключены даже при трёх включённых разрешениях. Проверить проводку, полярность внешних 5 В и общую землю, затем командой STATUS убедиться в `outputs=0`. Для проверки только проводки можно временно выключить OUTPUTS_ENABLED; для движений вернуть его после проверки. POWER остаётся информационной командой и не требуется для запуска:

```text
POWER monitor=NONE voltage_feedback=UNAVAILABLE
```

Это означает отсутствие измерения, а не исправность источника. Перед первым включением проверить полярность внешних 5 В и общую землю. Подтверждать показания АЦП и настраивать пороги больше не требуется.

## Если при 1500 мкс есть упор

1500 мкс — опорная электрическая команда сервоприводу, а не заданное положение звена MeArm. Ориентация качалки на шлицах и сборка тяг определяют механическую позу. Возможны неправильная установка качалки, перепутанное звено, перетянутый шарнир или иной механический упор.

**Если упор возникнет снова, не выполнять общий `SEED 1500,1500,1500,1500` и `ARM` в таком состоянии.** `ARM` сразу включает все четыре канала; последующий JOG и малая скорость не устраняют риск первого включения. Наличие программного диапазона также не подтверждает свободный ход.

1. Если привод уже гудит и давит в упор, поддержать звенья и сразу физически отключить питание приводов. Не ждать ответа консоли. Остановить или перезапустить ESP32 без питания приводов; аппаратное разрешение `arm_calibration` оставить выключенным.
2. При отключённом питании снять качалку проблемного привода с вала либо отсоединить тягу так, чтобы вал и качалка двигались свободно. Поддерживать остальные звенья. Проверить шарниры и правильность сборки; не проворачивать редуктор силой.
   Если одновременно упираются плечо и второй рычаг, они могут ограничивать друг друга через тяги. Поддержать всю верхнюю часть руки и разъединить передачу от обоих проблемных приводов перед их отдельной проверкой. В рабочей распиновке плечо использует GPIO26, второй рычаг GPIO27; для одиночной `servo_bench` каждый из них временно подключается к GPIO25.
3. Для центрирования использовать отдельную `servo_bench`. Подключить только этот ненагруженный SG90: сигнал GPIO25, внешние 5 В, общая GND. Остальные приводы отключить от питания и сигнальных проводов. Переподключать только без питания. Загрузить `servo_bench.ino` при отключённых приводах, затем включить питание ESP32 и привода. В мониторе 115200 бод отправить `CONFIRM`, затем `ARM 1500`. В текущем `servo_bench/LocalConfig.h` разрешение уже включено; PWM до этих команд не выдаётся.
4. После остановки вала отправить `DISARM`, отключить питание и переставить качалку по инструкции своей версии MeArm, сохраняя положение вала. Не задавать всем качалкам одинаковое направление: их монтажная ориентация различается. Сначала проверить 1500 мкс на том же одиночном приводе с тягой ещё отсоединённой; затем снова отключить питание и восстановить тягу.
5. Повторить для остальных проблемных узлов. К общему ARM возвращаться только после проверки, что все четыре монтажные команды и небольшой диапазон вокруг них не вызывают упора в собранном механизме.

В обновлённой `servo_bench` подтверждение CONFIRM действует 5 минут; PWM снимается через 5 минут без принятой команды и через 30 минут полной сессии. В активном режиме команды STATUS/HELP также продлевают ожидание на 5 минут, но не общий срок сессии. Диапазон свободного привода остаётся 1400–1600 мкс. Отключение PWM само по себе не отключает питание. Все работы с качалками и тягами выполнять при физически отключённом питании.

Порядок центрирования и установки качалок приведён в [официальной инструкции MeArm](https://shop.mearm.com/pages/building-the-mearm-robot-arm-wifi-kit); геометрию сборки выбрать для [своей версии](https://shop.mearm.com/pages/finding-out-your-mearm-version).

Сохранить иной монтаж и использовать разные SEED можно только при известных, проверенных свободных командах каждого привода. Если они вне установленных индивидуальных границ, понадобятся другие пределы в `LocalConfig.h`. Не искать такую команду произвольным ARM собранной руки: прошивка не измеряет реальное положение вала и не обеспечивает плавного подхода к первоначальному SEED.

## Пределы и исходная команда

Поддержать руку и убрать детали. В LocalConfig.h используются следующие индивидуальные границы:

| Канал | Минимум, мкс | Максимум, мкс | Подтверждённое наблюдение |
|---|---:|---:|---|
| 0 — основание | 550 | 2450 | Пользователь наблюдал свободный диапазон 500–2500 |
| 1 — плечо | 850 | 2150 | Пользователь наблюдал свободный диапазон 800–2200 |
| 2 — второй рычаг | 500 | 1650 | Ранее 600–1700; отдельно подтверждены две нижние позы карты с командой 500 |
| 3 — захват | 950 | 2100 | Открыто 2100; пустой контакт 900 исключён; удержание нынешней детали при 1250 подтверждено пользователем |

Это рабочие границы команд с запасом по наблюдениям пользователя, а не доказательство полной пространственной рабочей области. Наличие `LIMITS_CONFIRMED=true` не подтверждает совместные позы связанных звеньев или маршруты сортировки. При изменении механики, губок или позы остальных суставов повторить проверку и при необходимости уменьшить пределы.

В текущем файле сохранены следующие значения пользователя:

```cpp
constexpr bool OUTPUTS_ENABLED = true;
constexpr bool PINOUT_CONFIRMED = true;
constexpr bool LIMITS_CONFIRMED = true;
```

Для начала использовать последовательность из быстрой проверки выше. После дальнейших перемещений вводить последнюю записанную текущую команду, а не автоматически возвращаться к 1500. У SG90 нет обратной связи; первое `ARM` может вызвать рывок к введённой команде. `SUPPORTED` подтверждает опору оператором, а не обнаруживает её датчиком.

## Команды и время ожидания

Положительный шаг увеличивает команду канала, отрицательный уменьшает. Пользователь определил направления плюса: канал 0 — против часовой стрелки при взгляде сверху, 1 — опускает звено, 2 — от основания, 3 — открывает губки. Минус действует в обратную сторону. Это направления суставов, не отдельные оси X/Y/Z. Новый JOG или MOVE подавать после завершения предыдущего движения, в `HOLDING`. Очередь команд не поддерживается.

| Команда | Действие |
|---|---|
| `SEED us0,us1,us2,us3` | Задать начальные команды только в DISARMED; PWM не включается |
| `SUPPORTED` | После SEED однократно подтвердить опору руки |
| `ARM` | При всех подтверждениях и исправных входах включить четыре канала; подтверждение опоры расходуется даже при отказе |
| `JOG index delta_us` | Шаг от −100 до 100 мкс, кроме нуля; итоговая команда обязана остаться в пределах канала |
| `MOVE us0,us1,us2,us3` | В HOLDING плавно перейти к четырём абсолютным импульсам в границах каналов; JOG-лимит 100 к размеру этого перехода не применяется |
| `TRIALRED` | Из PARK 1500,1200,1500,2100 один раз выполнить красный перенос после настоящего снимка и проверить пустое поле после возврата в тот же PARK; без повторной попытки |
| `AIMRED` | Из PARK получить один снимок и подвести открытый захват к верхней позе над одной красной деталью; без спуска |
| `SORT` | Из PARK отсортировать ограниченную партию красных и синих деталей по координатам камеры; после каждого переноса проверить новую сцену; без повторной попытки |
| `HOLD` | В HOLDING продлить ожидание ещё на 5 минут; движения нет |
| `POSE` | В HOLDING вывести четыре команды и продлить ожидание на 5 минут |
| `POWER` | Сообщить об отсутствии измерения питания; в HOLDING продлить ожидание |
| `STATUS`, `HELP` | Состояние и помощь; в HOLDING продлить ожидание |
| `DISARM` | Снять PWM и забыть стартовую команду |
| `ESTOP` | Снять PWM с фиксацией FAULT |
| `RESET` | Сбросить FAULT в DISARMED; затем заново SEED, SUPPORTED, ARM |

Скорость изменения команды не выше 300 мкс/с: JOG на 50 мкс занимает примерно 0,18 с, на 100 мкс — примерно 0,34 с при регулярных обновлениях каждые 20 мс. Реальные скорость и угол вала этим не измеряются. Просроченный цикл не компенсируется большим скачком.

Через **5 минут** без принятой команды, продлевающей ожидание, все PWM снимаются. Для спокойного измерения достаточно периодически отправлять POSE или STATUS в HOLDING. Полная сессия ограничена **30 минутами**: записать POSE, поддержать руку, выполнить DISARM и для новой сессии ввести последние записанные команды через SEED, затем SUPPORTED и ARM. Если сессия закончилась ошибкой, перед этими командами выполнить RESET.

| Что появилось в мониторе | Что делать |
|---|---|
| JOG отклонён: целевая команда вне MIN/MAX | Посмотреть указанные границы и выбрать меньший шаг; не расширять предел без проверки механики |
| `WAIT_FOR_HOLDING` | Дождаться конца движения, отправить STATUS и повторить команду |
| `SEED_REQUIRED_OR_INVALID` | В DISARMED ввести четыре известные команды в пределах каналов |
| `SUPPORT_CONFIRM_REQUIRED` | Поддержать руку, отправить SUPPORTED, затем ARM |
| `ENABLE_LOST` или `permit=0` | Проверить переключатель 3V3–GPIO32; после остановки RESET и новые SEED/SUPPORTED/ARM |
| `HOLD_LEASE_EXPIRED` | Истекли 5 минут: выходы отключены, нужны новые SEED/SUPPORTED/ARM |
| `SESSION_TIME_LIMIT` | Истекли 30 минут: RESET, затем новые SEED/SUPPORTED/ARM |
| Привод гудит и давит в упор | Сразу физически снять питание с поддерживаемой руки; исправить механическую причину |

На опирающейся руке проверить размыкание GPIO32: ожидаются `FAULT`, `ENABLE_LOST`, `outputs=0`. Замыкание не должно возобновить движение. После восстановления ENABLE нужны RESET и новые SEED/SUPPORTED/ARM. Задержка цикла более 250 мс и обнаруженная ошибка PWM также останавливают выходы. При зависании процессора программный вход не заменяет физическое отключение.

**Отключение только питания SG90 теперь не обнаруживается.** При работающей ESP32 PWM может оставаться активным, а возврат 5 В может вызвать движение к текущей команде. Перед отключением питания поддержать звенья и выполнить DISARM. Если 5 В уже пропали, выполнить DISARM при работающей ESP32 **до** их восстановления. Новый запуск требует актуальной известной команды SEED, SUPPORTED и ARM. Для аварийного упора физическое отключение выполняется сразу, затем остановка программы при обесточенных приводах.

Ручной поиск диапазонов завершён наблюдениями пользователя; рабочие MIN_US/MAX_US заданы индивидуально, включая подтверждённое расширение нижней команды рычага до 500 для двух поз. Не возвращать всем каналам 500–2500 ради будущей автоматической сортировки. До приближения к препятствию уменьшать шаг до 10–25 мкс; если движение прекратилось или появился упор, сразу остановить питание, а не продолжать поиск. Повторяемость захвата нынешней детали подтверждена пользователем, узлы карты записаны; повторяемость поз, опора при снятом PWM и маршруты ещё требуют отдельной проверки.

## Записать положения для сортировки

**Статус:** исходные узлы карты и реальный верхний центр сохранены; нижний пока не измерен. По просьбе пользователя PARK заменён импульсами 1500,1200,1500,2100, его XYZ теперь пусты и measured_ok=false; прежняя запись PARK сохранена отдельно как история. Пункты ниже описывают получение и уточнение карты, повторно снимать её целиком сейчас не требуется. Ручной красный перенос этапа 12 и виртуальный цикл этапа 14 завершены; текущий этап 17 — ограниченная партия SORT со снимками из PARK. Подбор нижнего центра сейчас не выполняется. Положение камеры, основания и оси остаются прежними.

### 1. Подготовить стенд и файлы

Закрепить основание на столе, оставить доступную опору для звеньев и свободный выключатель питания приводов. Убрать детали из зоны случайного движения. Камеру, основание и разметку XY сохранить в прежнем положении: пользователь подтвердил, что они не менялись, а высота деталей остаётся 27 мм.

Подключение остаётся прежним: SG90 напрямую к GPIO25/26/27/33; **на каждом сигнале 10 кОм к общей GND**, всего четыре резистора. Все SG90 получают внешние 5 В, ESP32 — USB, земли объединены. Внешний плюс приводов не соединять с 5V/VIN USB-питаемой ESP32. Разрешение — переключатель `3V3 → GPIO32`; GPIO23/34 оставить неподключёнными. Делитель и преобразователь уровней не нужны. Для ручной карты камера и UART не обязательны, но положение камеры физически сохраняется.

Открыть папку `measurements/mearm_setup/`:

| Файл | Что записывать |
|---|---|
| `motion_calibration.csv` | 14 исходных поз и две дополнительные строки центров; LOW пока пустая |
| `map_settings.csv` | Границы выбранного прямоугольника и общие нижнюю/верхнюю высоты |
| `pose_repeatability.csv` | Повторные подходы, направление подхода, нагрузку, координаты и результат |
| `joint_limits.csv` | Уже сообщённые диапазоны отдельных приводов |
| `gripper_positions.csv` | Открытие 2100, удержание нынешней детали 1250; пустой контакт 900 — только наблюдение |

В исходных 14 строках записаны реальные координаты и команды, `gripper_open_us=2100`, `measured_ok=true`. Дополнительная строка `grid_center_high` содержит реальный центр; `grid_center_low` пока пустая с `measured_ok=false`. В `pose_repeatability.csv` есть одиннадцать контрольных записей; просветы маршрутов пока пусты. Флаги измеренных узлов не подтверждают маршруты.

### 2. Использовать ручную прошивку и текущую конфигурацию

Работать только через `firmware/arm_calibration/arm_calibration.ino`. Монитор: **115200 бод**, окончание строки «Новая строка». Сначала сохранить POSE и отправить HELP. На самой плате должны выводиться:

```text
Max step 100 us; rate 300 us/s; idle 300 s; session 1800 s from ARM. Wait HOLDING between moves.
LIMIT channel=0 min_us=550 max_us=2450
LIMIT channel=1 min_us=850 max_us=2150
LIMIT channel=2 min_us=500 max_us=1650
LIMIT channel=3 min_us=950 max_us=2100
```

Команда MOVE уже использована в подтверждённом этапе 11; новая загрузка для этапа 12 не нужна. В HELP она должна присутствовать наряду с указанными пределами и временем. В последующих сеансах, если на плате уже версия с MOVE, значения совпадают и рука в HOLDING, новый ARM не нужен. Если пределы другие, сохранить POSE; при командах вне новых границ сначала по проверенному пути JOG в прежней прошивке перейти в известную позу внутри них. Записать её POSE, поддержать опорой, DISARM, выключить 5 В и загрузить обновлённый скетч. Включение после загрузки выполнять из сохранённой физически известной позы.

В `LocalConfig.h` уже установлено:

```cpp
OUTPUTS_ENABLED = true;
PINOUT_CONFIRMED = true;
LIMITS_CONFIRMED = true;
MIN_US = {550, 850, 500, 950};
MAX_US = {2450, 2150, 1650, 2100};
MAX_STEP_US = 100;
RATE_US_PER_SECOND = 300;
INACTIVITY_MS = 300000;   // 5 минут
MAX_SESSION_MS = 1800000; // 30 минут
```

Это выдержка значений для сверки, не новый фрагмент для вставки поверх объявлений. `motion_node` на этом этапе оставить `VIRTUAL_MODE=true`, `MOTOR_OUTPUTS_ENABLED=false`; флаги геометрии, маршрутов и парковочной опоры там ещё не включать.

Если прошивка была перезапущена: опора должна сохранить известную позу. Ввести `SEED` с последними записанными четырьмя импульсами, затем `SUPPORTED`, затем `ARM`. Числа 1500 для всех — лишь пример ранее проверенной позы; не использовать их как универсальную безопасную парковку. ARM сразу включает начальные команды. Если после снятия PWM рука опустилась, сохранённая команда не доказывает её фактическое положение: сначала восстановить известную позу, а не отправлять ARM вслепую.

### 3. Общий способ подбора и записи каждой точки

1. Отправить POSE и сохранить текущие четыре команды.
2. При свободном пути менять один канал шагом 50–100 мкс; около нужной точки — 10–25 мкс. Одна команда JOG, затем дождаться HOLDING. Заранее проверить зазоры связанных звеньев. Из направления сустава нельзя вычислить конкретный шаг по X/Y/Z без измерения.
3. Для карты открыть захват до **2100** шагами в пределах 100 и последним остатком. Команда удержания **1250** записывается отдельно, не в 14 открытых поз.
4. В HOLDING измерить координаты, отправить POSE и вписать строку карты. POSE и STATUS продлевают ожидание на 5 минут. DISARM после каждой точки не нужен: переходить к следующей по проверяемому свободному пути.
5. Всю карту не требуется снимать за одну 30-минутную сессию. До конца каждой сессии сохранить POSE, поддержать руку и выполнить DISARM. Для нового запуска снова нужны известный SEED, SUPPORTED и ARM, только если опора физически сохранила или позволила восстановить известную позу; если была ошибка — сначала RESET. DISARM нужен в конце сеанса и при проверке парковочной опоры, а не после каждой строки карты. При упоре физически снять питание сразу.

### 4. Сохранить прежние координаты и правильно измерить Z

Использовать прежний ноль и направления осей камеры; не назначать новый ноль под основанием руки. Текущий `calibration_id=1573755510`. Камерные метки имели X=15/80/150 мм и Y=15/60/105 мм — это привязка камеры, а не доказательство досягаемости всего такого прямоугольника рукой.

X/Y точки захвата — проекция центра между губками на размеченную плоскость стола в этих прежних осях. Измерять линейкой/разметкой; положение камеры должно остаться прежним. Z — высота **самой низкой части пальцев над столом**. Нижний рабочий Z выбрать по фактическому захвату детали с зазором от стола; верхний — по проходу над препятствиями и бортами с реальным запасом. Проходить должны и пальцы, и удерживаемая деталь, если она свисает ниже пальцев; просвет проверять для всей геометрии руки с грузом. Z в карте всё равно измеряется по пальцам.

**27 мм — высота деталей и плоскости калибровки камеры, а не автоматически нижний Z пальцев.** Верхний и нижний Z не назначаются из виртуального примера.

### 5. Найти PARK и HUB

Сначала подобрать PARK с открытыми губками: звенья могут лежать на устойчивой опоре при выключенном PWM, рука не закрывает камере область сортировки. В HOLDING измерить X/Y/Z и записать POSE в `park_supported` **до** DISARM. Затем поддержать руку и выполнить DISARM, проверить, принимает ли опора вес и сохраняется ли поза. Если рука падает или смещается, доработать опору и не отмечать парковку проверенной. Для дальнейшей работы восстановить известную позу и явно выполнить SEED/SUPPORTED/ARM.

Подобрать HUB — свободную промежуточную позу между парковкой, полем деталей и контейнерами. Записать её X/Y/Z и POSE в `hub`. Проверить подход к HUB с обеих сторон по доступному пути, наблюдая связанные звенья и провода. Высокая конечная точка не гарантирует высокий или прямой путь до неё.

### 6. Выбрать небольшой достижимый прямоугольник и два уровня

От HUB сначала подобрать доступную пробную точку в центре будущей области. Затем выбрать **малый прямоугольник**, все четыре угла которого доступны без предельных положений. Не брать автоматически всё поле камерных меток. В `map_settings.csv` заполнить `pick_min_x_mm`, `pick_max_x_mm`, `pick_min_y_mm`, `pick_max_y_mm` в прежних осях.

Выбрать нижний уровень `low_z_lowest_tip_mm` по фактической высоте захвата нынешней детали и верхний `high_z_lowest_tip_mm` по свободному подходу. Значения измеряет оператор. Четыре нижних угла должны иметь **одинаковый нижний Z**, четыре верхних — **одинаковый верхний Z**. Для каждой пары low/high X и Y совпадают: карта предназначена для двух уровней над теми же углами.

### 7. Снять восемь поз углов

С открытием 2100 сначала снять четыре верхние позы: minX/minY, maxX/minY, minX/maxY, maxX/maxY. Для каждого угла подобрать ту же X/Y на нижнем уровне, записать low-позу и вернуться вверх по наблюдаемому свободному пути. Не перемещать руку между углами близко к столу; проходить через проверенный подъём/HUB.

После каждого измерения вписать реальные координаты и команды в соответствующую строку. Если нужная точка недостижима в рабочих пределах или пары low/high не удаётся получить на одинаковых X/Y, уменьшить или сместить выбранный прямоугольник. Не выдумывать команды и не расширять пределы ради четырёх углов.

### 8. Снять четыре позы контейнеров

Закрепить контейнеры. `bin1` — красный класс 1; `bin2` — синий класс 3. Для каждого подобрать с открытием 2100 верхнюю позу над местом сброса и позу разгрузки. Верхняя должна обеспечивать проход над бортом с запасом для пальцев и свисающей ниже них детали; нижняя — отпускание детали в контейнер без удара губок о дно или стенки. Записать `bin1_high`, `bin1_drop`, `bin2_high`, `bin2_drop`.

Высоты задаются реальными измерениями, а не готовыми числами. Проверить путь через HUB к контейнеру и обратно с учётом всей длины звеньев. Получаются **14 OPEN-поз: 2 PARK/HUB + 8 углов + 4 контейнера**. Закрытие 1250 для нынешней детали остаётся отдельным параметром.

### 9. Заполнить CSV и понимать соответствие прошивке

В `motion_calibration.csv` координаты записываются **в миллиметрах**, импульсы — **в микросекундах**. Десятичный разделитель — точка. Поле `measured_ok=true` ставить только после реального измерения этой позы. Поле `min_clearance_along_routes_mm` оставить пустым до измерения всего пути: зазор в конечной точке не является зазором маршрута.

| Строка CSV | Будущее поле MotionCalibration |
|---|---|
| `park_supported`, `hub` | `parkOpen`, `hubOpen` |
| `grid_minX_minY_low/high` | `grid[0].lowOpen/highOpen` |
| `grid_maxX_minY_low/high` | `grid[1].lowOpen/highOpen` |
| `grid_minX_maxY_low/high` | `grid[2].lowOpen/highOpen` |
| `grid_maxX_maxY_low/high` | `grid[3].lowOpen/highOpen` |
| `grid_center_low`, `grid_center_high` | Дополнительные узлы `centerLowOpen`, `centerHighOpen`; используются только при отдельном включении соответствующего уровня |
| `bin1_high`, `bin1_drop` | `binHighOpen[0]`, `binDropOpen[0]`, красный |
| `bin2_high`, `bin2_drop` | `binHighOpen[1]`, `binDropOpen[1]`, синий |

`base_us`, `shoulder_us`, `linkage_us`, `gripper_open_us` соответствуют каналам `[0]`, `[1]`, `[2]`, `[3]`. Для PARK/HUB/контейнеров X/Y/Z перейдут в `tip.x10/y10/z10` с умножением на 10. Для углов координаты задаются общими границами прямоугольника и высотами; они должны совпасть с измеренными строками. Например, 50,0 мм → 500 единиц прошивки. Импульсы на 10 не умножаются.

В `map_settings.csv` границы pick_min/max_x/y_mm соответствуют `pickMin/MaxX10/Y10`, нижний/верхний Z — `lowZ10/highZ10`; тоже умножение мм на 10. Текущие значения: X=20…130, Y=25…80 мм, Z=10/100 мм. `calibration_id` сохраняется 1573755510, `gripper_open_us=2100` соответствует `openUs`, `gripper_closed_for_part_us=1250` — `closedUs` для нынешней детали. camera_plane_height_mm и part_height_mm равны 27 и **не заменяют lowZ10**. В motion_node общие границы X=−60…255, Y=−30…80, Z=10…110 мм охватывают записанные конечные точки; они не подтверждают область всех путей. Заданные скорость 100 мкс/с и ускорение 100 мкс/с² ещё требуют физических испытаний.

Ниже **синтетический пример только формата**, не измеренная поза и не строка для копирования в рабочую карту:

```csv
node_id,x_mm,y_mm,z_lowest_tip_mm,base_us,shoulder_us,linkage_us,gripper_open_us,measured_ok,min_clearance_along_routes_mm,notes
grid_minX_minY_low,50,60,12,1500,1400,1450,2100,false,,СИНТЕТИЧЕСКИЙ_ПРИМЕР_НЕ_ИЗМЕРЕНИЕ
```

### 10. Проверить повторяемость и промежуточные точки

Подойти к каждой точке с разных направлений, повторить измерение без груза, затем с нынешней деталью. Полные команды, направление подхода, нагрузку, измеренные X/Y/Z и результат сохранить в `pose_repeatability.csv`; число фактически выполненных повторов фиксировать по записям. Сравнить разброс с зазором губок, стола и контейнеров. Угловые позы OPEN снять без детали; нагруженные проверки записывать отдельно, не заменяя их закрытыми командами в основной карте.

Исходная билинейная карта из четырёх углов дала верхнюю команду `1438,1525,1300,2100`, но фактический центр оказался 75/65/100 мм вместо 75/52,5/100. Это отклонение сохранилось после возвратов рычага ±25. Затем вручную найден и принят реальный центр **75/52,5/99 мм при 1441/1426/1220/2100**. Он записан отдельным узлом, исходные углы сохранены. Нижняя команда среднего четырёх углов не проверена и не служит готовым подходом к Z=10.

Карта теперь поддерживает отдельный центр каждого уровня: четыре треугольника сохраняют угловые узлы и добавляют измеренную центральную позу. В текущем motion_node `centerHighEnabled=true`: используется реальный центр 75/52,5/99 мм. `centerLowEnabled=false`: снизу пока действует прежняя билинейная карта. Пока нижний центр не измерен, его не включать; частично уточнённая карта не допускается для аппаратной сортировки. Проверить середины рёбер, точки внутри треугольников и повторные подходы с разных направлений. Центральный узел, использованный для настройки, не считается независимым доказательством точности; дополнительные строки журнала сами карту не меняют. Допустимый разброс выбирать по реальному зазору губок и размерам детали. При неприемлемой ошибке уменьшить поле или уточнить модель.

**Один JOG меняет один сустав. Автоматическая программа одновременно интерполирует несколько импульсов, поэтому ручной путь не проверяет её синхронный маршрут.** Конечные точки и отдельные суставные пределы не доказывают отсутствие столкновений на переходах. Все 14 поз записаны; теперь проверить повторяемость, внутренние точки и просветы. Последующую проверку автоматических переходов проводить отдельным этапом.

До физических проверок маршрутов оставить `motion_node/LocalConfig.h` в `VIRTUAL_MODE=true`, `MOTOR_OUTPUTS_ENABLED=false`, а `geometryConfirmed`, `routesVerified`, `parkSupported` там не включать заранее. SIMPOWER относится к виртуальной проверке, физический контроль питания отсутствует. Исходные 14 поз и дополнительный верхний центр перенесены в `makeCalibration()`; последующее редактирование CSV само по себе прошивку не меняет. Программные проверки и сборка обновлённой motion_node прошли, но загрузки этой версии в плату и проверки новых автоматических маршрутов не было.

## Программные проверки

Сборка предназначена для ESP32 с Arduino core 3.3.12. `test_jog.cpp` проверяет команды и состояния общего контроллера; общий API сохраняет аргумент наличия питания для программных имитаций. В текущем аппаратном профиле этот аргумент не связан с датчиком. Дополнительная проверка `.ino` с имитацией GPIO/LEDC охватывает выключенные настройки, запуск, JOG, отключение ENABLE и отсутствие обращения к GPIO23/34. Эти проверки не двигают реальные приводы и не подтверждают механические диапазоны.
