font-weight/sorter_esp32/docs/commissioning.md

# Порядок наладки

Текущая заданная скорость `arm_calibration` — **300 мкс/с**, втрое выше прежних 100 мкс/с. Она применяется к SORT, CHECKPICK, TRIALRED, AIMRED, MOVE и JOG, включая привод захвата. Отступ 25 мм, конечные позы и паузы сохранены; полное время партии не обязано уменьшиться втрое. Для применения пересобрать и загрузить arm_calibration в WROOM с обновлённой библиотекой `libraries/SorterCore`: в ней допустимая скорость увеличена до 300 мкс/с. В HELP должно появиться `rate 300 us/s`. Прежнее подтверждение работы относится к 100 мкс/с; результат на реальной руке при 300 мкс/с ещё не получен.

**Принятый вариант: боковой заход +Y на 25 мм. Пользователь подтвердил: «Все. работает. Оставляй».** В arm_calibration команды SORT и CHECKPICK сначала подводят захват к (X,Y−25) на верхнем уровне, опускают там, затем перемещают открытый захват к (X,Y) по нижней карте. Детали должны находиться при X=20…130, Y=50…80 мм. После закрытия выполняется подъём у детали. Пользователь сообщил, что при прежнем отступе 15 мм рука всё равно упёрлась. Отступ 25 мм для кубика размером 30 мм задаёт начало на 10 мм перед ближней гранью. Пользователь подтвердил работу этого варианта; координаты и число выполненных переносов не сообщены. Подробности — в начале `firmware/arm_calibration/README.md`. Настройка сохранена; для её принятия повторная прошивка не требуется.

**История до принятия бокового захода 25 мм: неудачный захват SORT от 12.10.2026.** Пользователь сообщил, что у обоих кубиков рука ушла примерно на 10 мм вперёд и прижала их сверху. Уточнено направление +Y. После неудачного захвата пользователь сам передвинул кубик: уменьшение числа объектов и SORT_PICK_DONE не подтверждают физический перенос и не доказывают ошибку камеры. Момент появления смещения пока неизвестен. Результат записан в `measurements/commissioning/stage17_result.json`. После этой неудачи изменён способ подхода; работу варианта с отступом 25 мм пользователь впоследствии подтвердил. Программные проверки не подтверждают физическую точность захвата.

CHECKPICK выполнен в точке 115,4/42,3 мм: измерены HIGH 115/47/101, NEAR 122/58/30 и LOW 120/48/8 мм. Смещение меняется по высоте, наибольшее среди этих остановок +15,7 мм по Y в NEAR. После местной поправки получены HIGH=115/46/103, NEAR=115/46/30, LOW=115/46/10 мм. При боковом заходе на 15 мм пользователь снова сообщил об упоре. Вариант бокового захода +Y с отступом 25 мм затем проверен и принят пользователем: «Все. работает. Оставляй». Настройка сохранена; порядок работы — в начале README arm_calibration. Ручное перемещение деталей во время обычного SORT нарушает условие неизменной сцены; его счётчик после такого вмешательства не является доказательством захвата.

Фактическое подключение выполнять по `docs/wiring.md`: SG90 получают сигналы 3,3 В напрямую от GPIO25/26/27/33, один резистор 10 кОм от каждого сигнала к GND, отдельное питание около 5 В и общую землю с ESP32. KiCad оставлен в прежнем виде; его пути сигналов и питания не являются инструкцией новой проводки. Для `arm_calibration`, `motion_node` и `servo_diagnostic` используется ENABLE32 от переключателя на 3V3. Контроля силового питания нет; GPIO23/34 не подключаются. При потере 5 В оператор должен выполнить DISARM до их восстановления.

Каждый этап заканчивается сохранением результата. Переходить к следующему только после понимания причин отказов предыдущего.

## Этап 17: порядок SORT после устранения промаха

Этап 16 завершён в одной точке: пользователь прислал `AIM_TARGET x_mm=41.6 y_mm=70.1 predicted_z_mm=99.6 command_us=1537,1601,1303,2100` и подтвердил «все совпало». Это наблюдение совпадения центров сверху; фактическая Z и нижняя поза этим не измерены. Результат сохранён в `measurements/commissioning/stage16_result.json`. Этап 15 ранее завершился попаданием красной детали в контейнер без проблем.

Теперь в **arm_calibration** используется команда **SORT**: свежий снимок из PARK, наведение по координатам, захват, выбор красного или синего контейнера, возврат в PARK и следующий снимок. Каждая деталь проходит 14 поз; открытый захват — 2100 мкс, удержание нынешнего кубика — 1250 мкс. Камера, проводка и положение контейнеров прежние. Основная motion_node остаётся виртуальной; нижний центр и XYZ PARK не подменяются расчётами.

1. Если рука после AIMRED ещё удерживается над кубиком, вернуть её командами `MOVE 1500,1500,1500,2100`, затем `MOVE 1500,1200,1500,2100`. После каждой дождаться HOLDING и наблюдать свободный ход. Если она уже в PARK, эти перемещения пропустить. Поддержать PARK, DISARM, выключить силовые 5 В и загрузить обновлённую **arm_calibration только в WROOM**. Монитор — 115200, «Новая строка». Сборка SORT на Arduino ESP32 3.3.12 и программные проверки прошли; последующее физическое испытание выявило промах при захвате обоих кубиков, см. актуальный результат в начале документа.
2. При физически сохранённом PARK отправить `SEED 1500,1200,1500,2100`, `SUPPORTED`; включить 5 В и ENABLE32, затем `ARM`, дождаться HOLDING. SEED сообщает нынешнюю позу и сам руку не перемещает. После устойчивого удержания убрать мешающую опору.
3. После проверки свободного бокового захода поставить два одинаковых по размеру кубика: красный примерно **X40/Y60**, синий **X100/Y60 мм**. Центры должны быть в **X=20…130, Y=50…80 мм**; расстояние между любыми двумя центрами не меньше **30 мм**, лучше 40 мм. Убрать руки из зоны и отправить `SORT` один раз. Контейнер 1 — красный, контейнер 2 — синий.
4. До конца партии не добавлять и не убирать детали вручную. После каждого переноса программа возвращается в PARK, ждёт 800 мс и получает новый кадр. Проверяется исчезновение прежней цели в радиусе 8 мм, уменьшение числа деталей выбранного цвета ровно на одну и неизменное число другого цвета. Ошибка останавливает партию без повторного захвата.
5. При успехе ожидается `SORT_RESULT sorted=2 red=1 blue=1 returned_park_command=1; confirm bins by observation.` и state=HOLDING, trial=DONE, camera_action=SORT. Посмотреть, действительно ли обе детали внутри своих контейнеров. Командный результат сам этого не измеряет.
6. Если партия прошла без зацепов, гудения и промахов, повторить три партии по два кубика в (40,60) и (100,60) мм, меняя цвета местами. Из удерживаемого PARK снова отправлять `SORT`; сохранить каждую строку SORT_RESULT, ожидается sorted=2, red=1, blue=1. Детали перекладывать только между завершёнными партиями. Прежняя раскладка в два ряда с Y=35 мм для отступа 25 мм не подходит.
7. После завершения поддержать PARK, отправить DISARM и выключить силовые 5 В. Записать число доставленных в правильные контейнеры, промахов и время каждой партии; снять видео полного цикла для защиты.

За один запуск разрешены максимум 8 попыток переноса (sortAttempts) и 15 минут; ответ камеры ожидается 6 секунд. Лимит партии не отменяет абсолютные 30 минут ручной сессии. SORT, AIMRED и TRIALRED взаимно исключены. Ошибки `OBJECT_OUTSIDE_SORT_AREA`, `PARTS_TOO_CLOSE`, `TARGET_STILL_PRESENT`, `SCENE_CHANGED_UNEXPECTEDLY`, `SORT_ROUTE_INVALID`, `BATCH_TIME_LIMIT`, `CAMERA_TIMEOUT` требуют остановки и устранения причины, не автоматического повторения. При касании или сильном гудении — ESTOP либо разомкнуть ENABLE32. При выключении силовых 5 В выполнить DISARM до восстановления питания.

Это объединённое заключительное испытание стенда под наблюдением. Верхняя карта использует измеренный центр, нижняя — измеренные углы и интерполяцию между ними. Точный захват всей области, синий маршрут и повторяемость партии сейчас проверяются; нижний центр и XYZ PARK остаются неизвестны. Флаги geometry/routes/parkSupported основной motion_node не включаются. Подробная инструкция — `firmware/arm_calibration/README.md`.

## Этап 15: завершённый TRIALRED — справочный порядок

Ниже сохранены шаги выполненного опыта. Значения STATUS указаны как ожидаемые; пользователь прислал строку TRIAL_RESULT и подтвердил попадание в контейнер.

Получен пользовательский итог этапа 14: DONE, error=NONE, attempts=2, cleared=2, physical_pwm=0, seq=3, stale=0, batch_limit_ms=900000. Он сохранён в `measurements/commissioning/stage14_result.json` как история прежнего профиля и подтверждает полный виртуальный цикл с живой камерой. Теперь пользователь выбрал **PARK 1500,1200,1500,2100** для начала, обоих снимков и возврата TRIALRED. Прежняя HIGH 1600,1700,1350,2100 остаётся подходом над 20/80. Пользователь ранее подтвердил её физическую позу и CAMSCAN одной красной на отметке, без сырого OBJECT; count/color/±15 мм из нового PARK проверит TRIALRED. Дополнительные покомандные замеры XYZ сейчас не нужны.

1. Если настоящая прежняя arm_calibration сейчас HOLDING в подтверждённой HIGH, отправить MOVE 1500,1500,1500,2100, ждать HOLDING; затем MOVE 1500,1200,1500,2100, снова ждать HOLDING и наблюдать путь. Из HUB в PARK меняется только плечо на −300 мкс. Если физически известный PARK уже удерживается, переход пропустить. Если рука DISARMED или сместилась, не считать виртуальный STATUS её фактической позой и не ARM по слепому SEED. Поддержать новый PARK, DISARM и выключить силовые 5 В. Сохранить позу на время загрузки. Загрузить только новую **firmware/arm_calibration/arm_calibration.ino в WROOM**; камера прежняя. Обновлённая версия собрана на Arduino ESP32 3.3.12 и проверена программно. Монитор 115200 бод, «Новая строка»; агент плату не прошивал и приводы не запускал.
2. Проводка прежняя: прямые сигналы GPIO25/26/27/33 → SG90, по одному 10 кОм от сигнала к GND; внешние 5 В для приводов, USB ESP32 и общая земля. ENABLE32 — переключатель на 3V3, GPIO23/34 свободны. camera TX13 → WROOM RX16, WROOM TX17 → camera RX14, UART 115200 с уровнями 3,3 В. MicroSD не использовать, плюсовые линии разных источников не объединять. Камеру, контейнер, старые оси, свет и ID=1573755510 сохранить.
3. Пока 5 В приводов выключены, с сохранённым PARK и опорой отправить **SEED 1500,1200,1500,2100**, затем **SUPPORTED**. Включить 5 В и ENABLE32, отправить **ARM**, затем STATUS. Ожидать state=HOLDING, outputs=1, command_us=1500,1200,1500,2100, camera_uart=1. Если поза физически сместилась, не запускать ARM по старому SEED: эта команда не выполняет плавного восстановления.
4. Убрать опору, если она мешает пути и рука устойчиво держится. Поставить ровно одну прежнюю лёгкую красную деталь на отметку **X20/Y80**, с ориентацией успешного ручного захвата. Убрать руки из зоны и кадра, отправить только **TRIALRED**. Программа требует одного красного объекта и координаты в ±15 мм по каждой оси; допуск лишь фильтрует вход, захват остаётся фиксированным на прежней отметке.
5. Первый снимок выполняется из PARK. Наблюдать **14 переходов**: HUB_OUT → APPROACH_HIGH над 20/80 → NEAR → LOW → удержание 1250 → NEAR → HIGH → HUB с деталью → красные HIGH/DROP → открытие 2100 → HIGH контейнера → HUB_RETURN → PARK_RETURN. Текущая заданная скорость arm_calibration 300 мкс/с; движение согласуется по импульсам, не по прямой XYZ. MOVE/JOG или другие запросы камеры во время опыта не отправлять. **Оператор деталь не убирает; SIM_REMOVE и повторной автоматической попытки нет.** При упоре, гудении, касании или сползании остановить ESTOP/ENABLE32, поддержать руку; при механическом упоре отключить силовые 5 В.
6. После **TRIAL_STEP 14/14 name=PARK_RETURN**, завершения движения и выдержки 800 мс программа запрашивает свежий кадр из PARK. Ожидать TRIAL_SCENE count=0 и **TRIAL_RESULT scene_cleared=1 returned_park_command=1**. На STATUS ожидаются HOLDING, outputs=1, command_us=1500,1200,1500,2100, camera_uart=1, trial=DONE, trial_error=NONE. Пустой кадр не доказывает попадание в контейнер, а завершённая команда не измеряет физическое положение SG90: проверить оба глазами.
7. Поддержать **PARK** на опоре, отправить **DISARM**, после снятия PWM выключить силовые 5 В. Автоматического DISARM в успешном конце нет. Сообщить «взял / отпустил внутри красного / вернулся в PARK / проблемы» и скопировать TRIAL_RESULT с STATUS; при отказе — TRIAL_FAILED или TRIAL_REFUSED. Новые XYZ для этого опыта не нужны.

На ответ камеры отведено 6 секунд, на однократный опыт 3 минуты; ручное ожидание 5 минут, сессия 30 минут. Отказы ONE_RED_PART_REQUIRED/PART_OUTSIDE_TRIAL_POINT не начинают перенос; SCENE_NOT_EMPTY_AFTER_TRANSFER не запускает второй захват. CAMERA_TIMEOUT/CAMERA_RESTART требуют сохранить сообщение и остановиться. Полный порядок и таблица ответов — в `firmware/arm_calibration/README.md`.

Этап 15 выполнен пользователем, строка результата и наблюдение приведены выше. Основная motion_node остаётся VIRTUAL_MODE=true, MOTOR_OUTPUTS_ENABLED=false, PINOUT_CONFIRMED=false, UART_PROFILE_CONFIRMED=true; geometry/routes/parkSupported false, нижний центр неизвестен. TRIALRED использует фиксированный красный путь с добавленными выходом/возвратом PARK↔HUB. XYZ нового PARK не измерены: в карте только его импульсы, measured_ok=false; виртуальные координаты профиля не являются замером. Успех одного опыта не подтверждает интерполяцию всего поля, синий контейнер или измеренную парковку. Старые этапы 11/12 и итог 14 сохранены как история прежних команд.

## Этап 13: завершённая UART-диагностика, справка

В новой camera_node сканирование по CAMSCAN автоматически подсвечивается белым LED GPIO4: включение, пауза 100 мс, свежий кадр, выключение. Для этого обновления перепрошить только ESP32-CAM, motion_node и проводка прежние. Пороги и геометрическая калибровка сохранены; при засветке или ошибках цветов потребуется настройка освещения/цветовых порогов. Силовые 5 В приводов остаются отключёнными.

Пользователь подтвердил этап 12: доставил красную деталь в красный контейнер, отпустил внутри и вернулся, проблем нет. Вместе с успешным этапом 11 это два функциональных сообщения в `measurements/mearm_setup/functional_tests.csv`; 11 численных проб pose_repeatability.csv остаются прежними. В этапе 13 движения руки не выполнялись.

1. Поддержать руку и DISARM в текущей ручной прошивке. Выключить питание стенда, отключить силовые 5 В сервоприводов на весь этап. Зафиксировать руку на опоре вне обзора, сохранить камеру, основание, свет и старые оси.
2. Без питания соединить напрямую camera GPIO13 TX → WROOM GPIO16 RX, WROOM GPIO17 TX → camera GPIO14 RX, GND → GND. Уровни 3,3 В; microSD убрать, GPIO13/14 заняты UART. Каждой плате обычное питание от своего USB/программатора, плюсовые 5 В источников не объединять.
3. Загрузить camera_node в ESP32-CAM, motion_node с CAMSCAN в WROOM. Обе версии собраны на ESP32 3.3.12 и прошли программные проверки, пользователь затем сообщил, что UART и LED работают; сырые логи не предоставлены. На камере штатные GPIO1/3 остаются программированием/USB-консолью; после загрузки снять IO0–GND и перезапустить для RUN. Калибровка 1573755510, пороги, ROI и сенсорные настройки не меняются.
4. USB камеры 460800: STATUS должен дать CAMERA=1 UART=1 VISION_CONFIRMED=1 CALIBRATION=1 ID=1573755510. USB WROOM 115200: STATUS — mode=VIRTUAL_NO_PWM, DISARMED, outputs=0, uart=1, camscan_pending=0. Межплатный UART с обеих сторон 115200 8N1.
5. На WROOM отправить **CAMSCAN**, сначала без деталей. Ожидаются CAMSCAN_WAIT и CAMSCENE count=0. Затем отдельно разместить красную и синюю внутри поля X20…130/Y25…80, примерно около 50/45 и 100/65, не касаясь и не выходя всей областью за калиброванный участок. Ещё CAMSCAN: ожидаются count=2, OBJECT class=1 color=red и class=3 color=blue с x_mm/y_mm/pixels. Точная раскладка для этого этапа не нужна.
6. Скопировать CAMSCENE/OBJECT и STATUS управляющей платы после ответа; при отказе сохранить сообщение. CAMSCAN_TIMEOUT означает отсутствие подходящего ответа за 6 секунд, CAMSCAN_ERROR code=... — ответ E камеры. Команда одноразовая, принимает только DISARMED/DONE с виртуальным режимом и выключенными выходами.

ARM/PARKCONFIRM, ручная SCENE/CRC и новые POSE/замеры руки здесь не нужны. На USB камеры SCAN/SCAN_MM запрещены при UART=1: CAMSCAN отправлять с WROOM. Включено только разрешение UART; моторный режим, geometryConfirmed/routesVerified/parkSupported остаются false, нижний центр отсутствует. Новая геометрическая калибровка не требуется. Подробные шаги — в README camera_node и motion_node.

## 1 Камера: справка первоначальной настройки

Открыть camera_diagnostic/README.md. Уточнить профиль платы. Сначала прочитать модель чипа и память, затем включить подтверждённый профиль камеры. Получить серию кадров, сохранить изображение командой CAPTURE через инструмент компьютера. Цвет и порядок байтов проверить по красному, зелёному и синему образцам. Физическое положение камеры зафиксировать.

Результат: сведения о плате, размер PSRAM, число полученных и повреждённых кадров, исходное изображение. Пока нет кадров настоящей камеры, синтетические примеры подтверждают только работу программы.

## 2 Приводы вне механики

Использовать `servo_bench` для одного свободного SG90 либо открыть `servo_diagnostic/README.md` и подготовить ENABLE32. Подключить один привод к отдельному питанию, его сигнал — непосредственно к проверенному выводу второй ESP32 с резистором 10 кОм к GND, земли объединить. Вручную разрешить выход, двигать небольшими шагами возле центра, записывать наблюдение. Повторить для всех четырёх. `servo_bench` не предназначена для собранной руки. Ни одна из этих программ в текущем подключении не измеряет силовое питание.

Результат: рабочие пределы импульса, направление, монтажный центр, люфт и ток. Привод непрерывного вращения для позиционирования не подходит. Не проверять предельный момент длительным удержанием заблокированного вала.

## 3 Рука без зрения

Выставить центральные команды на свободных приводах, снять питание, установить качалки по инструкции выбранной версии MeArm без усилия на редуктор. Если в собранной руке плечо и связанный рычаг упираются при 1500 мкс, снять тяги и исправить монтаж до общего запуска. Проверить тяги, свободный ход и проводку. Отдельная прошивка `arm_calibration` позволяет медленно менять один сустав, удерживая остальные, и записывать команды поз. Проверить вход разрешения GPIO32; делитель и калибровка АЦП больше не нужны. Программа требует явной исходной команды `SEED`, подтверждения механической опоры `SUPPORTED` и отдельного `ARM`; подробности и флаги в её README. По одной позе найти парковку, точки подъёма и сброса; все движения сначала медленные. Контейнеры закрепить с низкими бортами. Перед восстановлением отключённых 5 В поддержать руку и выполнить DISARM.

Серию 30 переносов одной лёгкой детали из известной точки выполнять после проверки повторяемого захвата, измерения поз и маршрутов. Карта поз записана; ручной перенос в красный контейнер и виртуальный цикл с живой камерой подтверждены пользователем. Этап 15 с фиксированным красным переносом TRIALRED завершён; этап 16 подтвердил верхнее наведение в одной точке; текущий этап 17 объединяет проверку двух цветов, подбора в разных местах и повторяемости партии SORT. Если удержание ненадёжно, сначала исправить механическую причину; камера эту проверку не заменяет.

Пользователь сообщил наблюдения: основание свободно 500–2500 мкс, плечо 800–2200, второй рычаг ранее 600–1700. При снятии карты отдельно подтвердил две нижние позы с каналом 2 = 500 и изменил его MIN_US на 500. Рабочие границы теперь 550–2450, 850–2150, 500–1650 и 950–2100. Это результаты отдельных проверок, а не разрешение всех сочетаний связанных звеньев. Захват открыт при 2100; пустые губки касаются при 900; нынешняя квадратная деталь удерживается при 1250. Через HELP проверить текущие пределы, шаг 100, скорость 300 мкс/с, ожидание 300 с и сессию 1800 с. Сборка на компьютере не означает загрузку в плату. Если требуется загрузка, сначала сохранить текущий POSE, обеспечить известную поддерживаемую позу внутри новых границ по проверенному пути JOG, выполнить DISARM и выключить питание приводов. Не задавать SEED 1500 вслепую из другого положения.

Повторяемый захват нынешней детали при 1250 подтверждён пользователем; число выполненных повторов не сообщено. Для других размеров и форм удержание проверять отдельно: остановиться при устойчивом удержании, не усиливать сжатие ради числа. Пустой контакт 900 исключён из рабочих границ. Открытие для карты — 2100, удержание 1250 записывается отдельным параметром.

Пользователь подтвердил этап 11: одну деталь взял, поднял, удержал 5 секунд, вернул и отпустил; проблем нет. Один сообщённый успешный функциональный опыт записывается в `measurements/mearm_setup/functional_tests.csv`. Одиннадцать численных проб остаются отдельно в pose_repeatability.csv; новых координат пользователь не сообщал.

**Этап 12 выполнен по сообщению пользователя: красная деталь доставлена, отпущена внутри, рука вернулась, проблем нет.** Ниже сохранён прежний справочный порядок с HIGH в начале/конце; текущая TRIALRED использует новый PARK из начала документа. Подробные таблицы ручных команд остаются в `firmware/arm_calibration/README.md`. Тогда использовалась arm_calibration с MOVE без новой загрузки, изменения библиотеки и проводки. В HOLDING продолжалась существующая ручная сессия. Из DISARMED прежний SEED 1600,1700,1350,2100 → SUPPORTED → ARM использовался только при физически сохранённой HIGH на опоре. Он не является новым PARK. Если звенья сместились, сначала восстановить физически известное поддерживаемое положение, не ARM вслепую и не подставлять 1500 для всех каналов.

Сначала пустой проход по одной команде, после каждой ждать HOLDING: MOVE 1600,1700,1350,2100 → MOVE 1500,1500,1500,2100 → MOVE 2100,1600,850,2100 → MOVE 2100,1800,750,2100 → HIGH красного контейнера → HUB → HIGH над 20/80. Команды концов взяты из CSV; это не новая физическая проверка всей траектории. Наблюдать пальцы, звенья, провода и борт, без повторных замеров XYZ после каждой строки. При касании, упоре или сильном гудении поддержать руку и физически отключить питание.

После свободного пустого прохода поставить одну лёгкую красную деталь на 20/80. Открытая промежуточная 1600/2060/950/2100 → LOW 1600/2150/850/2100 → закрыть в LOW до 1250 → промежуточная закрытая → HIGH закрытая → HUB закрытая → HIGH красного контейнера закрытая → DROP 2100/1800/750/1250. После HOLDING подождать 1 секунду и открыть MOVE 2100,1800,750,2100. Вернуться через HIGH контейнера и HUB в HIGH над 20/80. На каждом MOVE ждать HOLDING, очереди нет; наблюдать удержание и просвет всей детали, включая часть ниже пальцев. Свободный путь без груза не доказывает путь с грузом.

Сообщить функциональный результат: доставил в красный, отпустил внутри, вернулся, проблемы. Синий контейнер ещё не проверен. Камера не участвует, XYZ заново не требуются. Полные проверки карты, нижнего центра и автоматических маршрутов отложены; флаги геометрии, маршрутов, парковки и аппаратных выходов остаются выключенными. Таймеры прежние: 5 минут ожидания и 30 минут сессии; STATUS/POSE продлевают только ожидание. В конце поддержать и DISARM; ESTOP и размыкание ENABLE32 также снимают PWM.

## 4 Координаты камеры

Использовать отдельную плоскость меток на высоте верхних поверхностей деталей. Собрать обучающие и независимые контрольные точки согласно docs/calibration.md. Преобразование подобрать инструментом calibrate.py. Проверить ошибки и знак каждой оси. Пример из examples никогда не признавать реальной калибровкой.

Матрица применима только при той же камере, фокусе, разрешении, обрезке/масштабе и геометрии установки. Если используются необработанные кадры с искажённым объективом, небольшой остаток на обучающих точках не доказывает малую ошибку между ними. Проверять контрольные точки по полю; при необходимости уменьшить поле либо отдельно компенсировать искажения.

## 5 Карта движения

Ниже сохранён порядок карты этапа 10; ручные функциональные этапы 11/12 и виртуальный цикл этапа 14 завершены, текущий этап 17 — ограниченная партия SORT. Исходные узлы сохранены, дополнительный верхний центр измерен, нижний пока отсутствует. Новый PARK записан только импульсами 1500,1200,1500,2100, его XYZ пусты и measured_ok=false; прежний PARK сохранён как история. Дополнительные замеры сейчас не выполняются. Автоматическая motion_node остаётся виртуальной; реальный однократный опыт проводится отдельной arm_calibration. Прежняя проводка SG90, положение камеры, основания и разметка сохраняются.

Записаны PARK (−55/0/13 мм; 2000/2000/700/2100 мкс), HUB (55/55/110 мм; 1500/1500/1500/2100 мкс), восемь углов и четыре позы контейнеров. Поле X=20…130, Y=25…80 мм; пользователь уточнил, что Y=85 было опечаткой. Точки не подтверждают опору при снятом PWM: её проверять отдельно с поддержкой и записанным POSE. Новый сеанс начинать из сохранённой физически известной позы SEED/SUPPORTED/ARM, не включать вслепую 1500 или целевой центр.

Сохранять прежний ноль, оси и `calibration_id=1573755510`. X/Y — проекция центра губок; Z — высота нижней части пальцев над столом. Подтверждённые 27 мм — высота детали и плоскости камеры. Z углов карты — 10 мм снизу и 100 мм сверху; принятый фактический верхний центр имеет **99 мм**, его не округлять до 100 ради уровня. X/Y каждой пары должны совпадать. Высокий подход должен пропускать над бортами пальцы и деталь, если она свисает ниже них; просвет проверять для всей руки с грузом.

Исходные 14 строк имеют открытие 2100 и `measured_ok=true`. Дополнительная `grid_center_high` содержит 75/52,5/99 мм и 1441/1426/1220/2100 мкс; `grid_center_low` пока пустая, `measured_ok=false`. Они соответствуют `centerHighOpen`/`centerLowOpen` при отдельном включении уровней в конфигурации; одного CSV недостаточно. Удержание нынешней детали 1250 хранится отдельно. Координаты из мм умножаются на 10, импульсы остаются в мкс. В журнале одиннадцать контрольных записей, просветы маршрутов ещё пусты. `measured_ok=true` относится к отдельной позе, не всей карте или пути. DISARM нужен при проверке PARK и в конце поддерживаемого сеанса, не после каждого измерения.

Исходное верхнее среднее четырёх углов 1438/1525/1300/2100 дало 75/65/100 мм и ошибку Y=+12,5 мм. Вручную найден и принят верхний центр **75/52,5/99 мм при 1441/1426/1220/2100**. Подбор нижнего центра вести отсюда по одной малой пробе с измерением после каждой, целевые X/Y=75/52,5 и Z около 10 мм. Старое нижнее среднее 1425/2075/675/2100 не подтверждено физически: не выполнять пакет команд к нему и не вводить его первым SEED. Следующий одиночный шаг указан в пункте 3 выше.

Новая карта поддерживает центр каждого уровня: четыре треугольника соединяют измеренный центр и исходные углы, внешние края сохраняют прежнюю интерполяцию. Верхний центр включён с реальными 75/52,5/99 мм; нижний отключён, там остаётся исходная билинейная карта. Частично уточнённая карта разрешена только для виртуальной проверки, не для аппаратной сортировки. Нижний уровень не включать до его реального измерения. Затем проверить другие внутренние точки и повторные подходы без груза, удержание нынешней детали при 1250 и просветы. Центр, использованный для настройки, не считается независимым доказательством точности; другие строки журнала сами карту не меняют. При неприемлемой ошибке уменьшить поле или уточнить модель. Путь губок по меняющимся импульсам не обязан быть прямым; пределы отдельных суставов не исключают столкновений связанных звеньев.

Одиночные JOG не проверяют синхронные автоматические переходы. До отдельных физических проверок маршрутов сохранить `motion_node/LocalConfig.h` с `VIRTUAL_MODE=true`, `MOTOR_OUTPUTS_ENABLED=false`; геометрию, маршруты и парковочную опору не подтверждать заранее. Общие границы X=−60…255, Y=−30…80, Z=10…110 мм охватывают записанные точки, но не доказывают траектории; заданные скорость и ускорение 100 ещё требуют физических испытаний. Полный порядок и соответствие полей прошивке приведены в README arm_calibration и motion_node.

## 6 Один объект по камере

Перед аппаратным запуском автоматической `motion_node` проверить ENABLE32, отключение PWM при его размыкании и отсутствие самозапуска после замыкания. Контроль силового питания в текущей прошивке отсутствует; при отключённых 5 В выполнить DISARM до их восстановления. Затем допустить измеренную карту и маршруты в конфигурации. Для нового автоматического запуска вернуть руку в измеренную парковку, выполнить PARKCONFIRM и ARM.

Открыть захват и поставить указатель вместо детали, если это удобно. Проверить попадание на метки по измеренным камерой координатам. Затем взять одну деталь. После возврата в парковку должен быть запрошен свежий кадр. Ошибка класса, устаревший ответ или потеря камеры не должны начинать новый перенос. Отключение силовой части останавливает оператор, поскольку датчика её состояния больше нет.

## 7 Партия и отказы

Начать с двух деталей разных цветов, затем с двух одного цвета. Не допускать касаний. Проверить пустой стол, посторонний цвет, выход за полезную область, неподвижную после неудачного захвата деталь. Число повторов ограничено, иначе робот может бесконечно пытаться взять один предмет.

## 8 Испытания для отчёта

Зафиксировать версию прошивки и калибровки. Провести серии за несколько сеансов. Успешный полный цикл означает правильный контейнер без вмешательства; неуспехи сохраняются в журнале. Для анализа используется analyze_run.py. Искусственный пример журнала нужен только для проверки инструмента и не включается в результаты курсовой как эксперимент.
