font-weight/sorter_esp32/tools/calibration_picker.html

# Точки калибровки камеры

Выберите центры меток на снимке и внесите измеренные координаты в миллиметрах. Страница подготовит CSV для расчёта калибровки.

ЛОКАЛЬНО · БЕЗ СЕТИ

1 · Открыть кадр2 · Нажать на центр метки3 · Ввести X / Y4 · Сохранить CSV

## Кадр камеры

Локальный PNG или JPEG

Новый файл очистит текущие точки. Сохраните их CSV перед заменой кадра.

Для рабочей прошивки camera_node нужен исходный кадр 320 × 240 без обрезки и поворота.

Ставить меткиИзмерить RGBКоординаты — в исходных пикселях

Сначала выберите снимок. Он останется на вашем компьютере.

train — расчёт матрицыtest — независимая проверка

Масштаб отображения не меняет пиксельные координаты. Режим RGB только показывает цвет и не добавляет метки. Цвет PNG отображается после преобразования браузером; это вспомогательная оценка, не автоматическая настройка порогов.

## Новая точка

Нажмите на центр метки слева. X и Y измерьте на стенде в системе координат руки; страница не определяет их по фотографии.

U — V —

Назначение точки

X, мм

Y, мм

Добавить точку

0 train0 test0 всего

Рекомендуется 9 train + 4 test, распределённых по рабочей области. Для экспорта нужно не менее 6 train + 3 test.

Отменить изменениеСохранить CSV

Повторные центры и одинаковые X/Y не допускаются. Контрольные точки ставьте между обучающими, внутри их внешней границы.

CSV содержит только введённые соответствия. Проверка геометрии, ошибка на контрольных точках и матрица рассчитываются отдельно в calibrate.py.

## Сохранённые точки

№ | Группа | U, px | V, px | X, мм | Y, мм | Действие
Точек пока нет.

Данные хранятся только в открытой вкладке. Закрытие или перезагрузка очистит их. Проверяйте высоту плоскости меток, разрешение, неподвижность камеры и направления осей перед расчётом.
