font-weight/sorter_esp32/examples/synthetic_calibration_layout.png

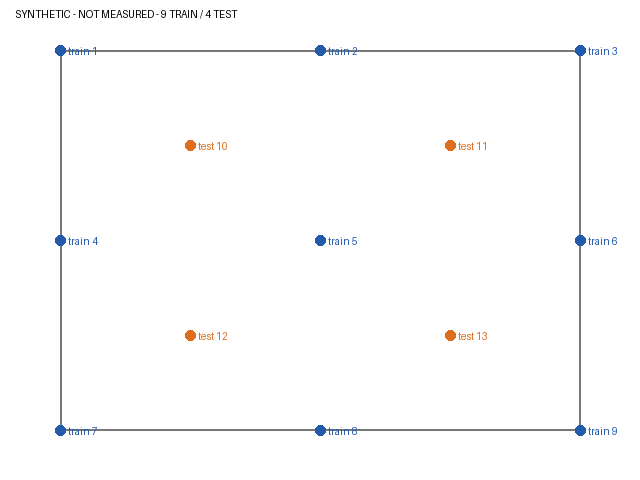
examples/synthetic_calibration_layout.png
