font-weight/sorter_esp32/firmware/camera_node/CameraConfig.h

#pragma once
#include <PartClasses.h>
#include <ColorDetector.h>

// Confirmed profiles for the assembled sorter.
constexpr bool CAMERA_PROFILE_CONFIRMED = true;
constexpr bool CAMERA_UART_PINS_CONFIRMED = true;
// Use the owner's previously checked red/blue thresholds and camera mapping.
constexpr bool VISION_CONFIG_CONFIRMED = true;
constexpr unsigned USB_BAUD = 460800;
constexpr unsigned CAMERA_UART_BAUD = 115200;
constexpr int CAMERA_UART_RX = 14; // Project KiCad: controller TX17 -> camera RX14; no SD.
constexpr int CAMERA_UART_TX = 13; // Project KiCad: camera TX13 -> controller RX16.

// GPIO4 flash illuminates each fresh scan requested over UART or USB.
constexpr bool SCAN_FLASH_ENABLED = true;
constexpr unsigned SCAN_FLASH_SETTLE_MS = 100;

// Fixed OV2640 settings used with the current thresholds and calibration.
// Recalibrate after changing these.
constexpr int SENSOR_EXPOSURE = 70; // 0..1200
constexpr int SENSOR_GAIN = 0;       // 0..30
constexpr int SENSOR_WB_MODE = 1;    // 1 sunny, 2 cloudy, 3 office, 4 home
constexpr bool SENSOR_HMIRROR = false;
constexpr bool SENSOR_VFLIP = false;

// Red and blue only. Keep thresholds tuned from the actual parts and lighting.
// Class 2 (green) is disabled; overlapping ranges are rejected as unknown.
const sorter::ColorRange COLOR_RANGES[] = {
  {sorter::kRedClassId, 200, 255, 0, 200, 0, 239, 60}, // red -> first bin
  {sorter::kBlueClassId, 100, 210, 100, 210, 175, 255, 50} // blue -> second bin
};
static_assert(sizeof(COLOR_RANGES)/sizeof(COLOR_RANGES[0]) == sorter::kColorCount,
              "The sorter must have exactly two color ranges");
const sorter::DetectorConfig DETECTOR_CONFIG = {
  COLOR_RANGES, sizeof(COLOR_RANGES)/sizeof(COLOR_RANGES[0]),
  {8, 8, 312, 232}, // half-open ROI in the calibrated 320x240 frame
  40, 6000, true   // pixel area range and ROI-edge rejection
};
