font-weight/sorter_esp32/(commit log)

2026-10-05 Sort red and blue parts into two bins
    [motion_calibration_template.csv, synthetic_run.csv]
2026-10-13 Release v1.0.0: final ESP32 two-color sorter
    Start sorting with SORT or the GPIO18 button and restore saved servo commands at startup.
    Keep calibrated side-entry routes and centralize speed configuration (current value: 800 us/s).
    Remove archived commissioning tools from the working project; include firmware, tests, instructions and algorithm diagram.
    Validation: all four host test suites pass; both ESP32 firmware targets compile with Arduino-ESP32 3.3.12. No hardware upload performed.
